pietwauters/ImprovedTesterAfterGenova/Enclosure/TesterInclSwitchv0.2e.3mf

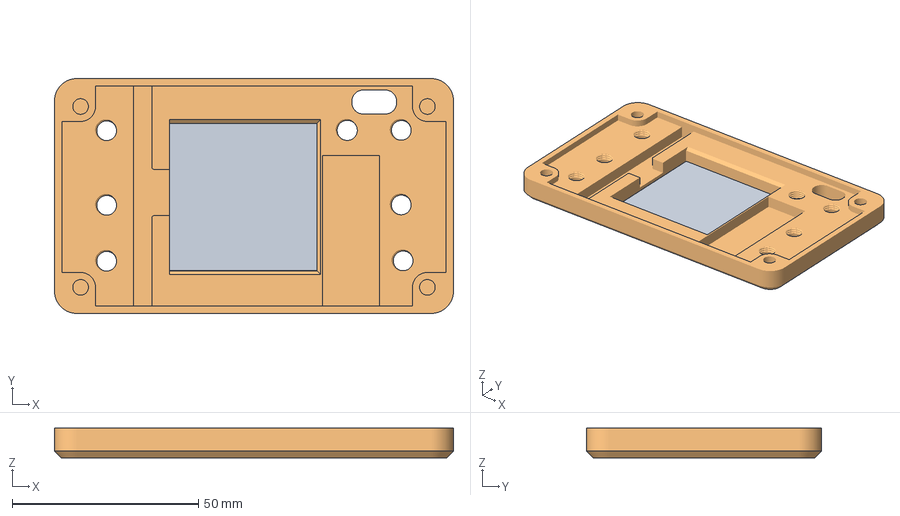
[picture p1: CAD file, 2026-11-05]
Enclosure/TesterInclSwitchv0.2e.3mf
107.0 x 63.0 x 8.00 mm
