pietwauters/ImprovedTesterAfterGenova/Enclosure/TesterInclSwitchv0.2eTop.3mf

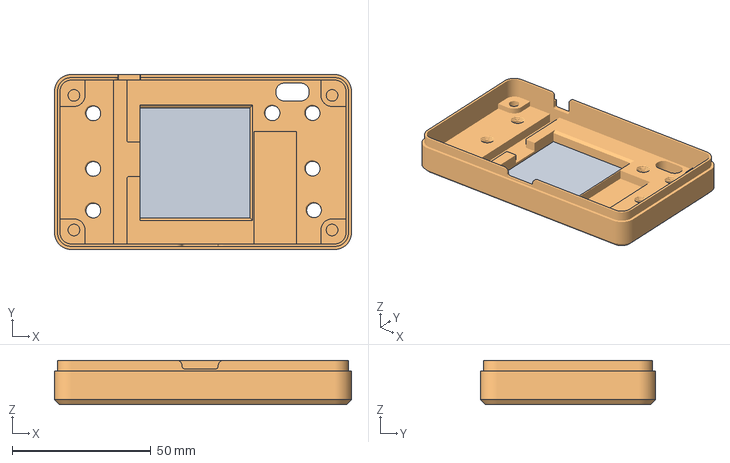
[picture p2: CAD file, 2026-11-05]
Enclosure/TesterInclSwitchv0.2eTop.3mf
107.0 x 63.0 x 16.0 mm
