pietwauters/ImprovedTesterAfterGenova/(list of files, cad)

Other CAD files:
Enclosure/TesterInclSwitchv0.2fTopWithout.3mf
