pietwauters/ImprovedTesterAfterGenova/src/main.cpp

#include <Arduino.h>
#include <AsyncTCP.h>
#include <ESPAsyncWebServer.h>
#include <ElegantOTA.h>
#include <WiFi.h>

#include <algorithm>
#include <cinttypes>
#include <cstdio>
#include <iostream>
#include <map>
#include <vector>

#include "PreferencesWrapper.h"
#include "SettingsManager.h"
#include "WS2812BLedMatrix.h"
#include "CalibrationService.h"
#include "WebTerminal.h"
#include "WiFiPowerManager.h"
#include "driver/adc.h"
#include "esp_adc_cal.h"
#include "version.h"
// Only include Bluetooth header if it's enabled in config
#ifdef CONFIG_BT_ENABLED
#include "esp_bt.h"
#endif
#include "esp_task_wdt.h"
#include "esp_timer.h"
#include "esp_wifi.h"
#include "freertos/task.h"  // Required for vTaskList()
#include "resitancemeasurement.h"
#include "terminal.html.h"
using namespace std;

#include <freertos/FreeRTOS.h>
#include <freertos/task.h>

#include "DisplayManager.h"
#include "DeepSleepHandler.h"
#include "GpioHoldManager.h"
#include "Hardware.h"  // HARDWARE_REV_STR
#include "RTOSUtilities.h"
#include "USBSerialTerminal.h"
#include "adc_calibrator.h"
#include "driver/gpio.h"  // Required for gpio_pad_select_gpio()
#include "driver/rtc_io.h"
#include "esp_log.h"
#include "soc/io_mux_reg.h"  // For IO_MUX register definitions
#include "tester.h"

/*#include "ESP32Button.h"
 */

void disableRadioForTesting() {
    Serial.println("=== TEMPORARILY DISABLING RADIO FOR TESTING ===");

    // Disable WiFi if it was initialized
    WiFi.mode(WIFI_OFF);
    WiFi.disconnect(true);

// Disable Bluetooth (if available)
#if defined(CONFIG_BT_ENABLED)
    btStop();
#endif

    Serial.println("Radio disabled - WiFi and Bluetooth are off");
}
// Global tester instance
Tester* tester = nullptr;

int myRefs_Ohm[] = {0, 1, 2, 3, 4, 5, 6, 7, 8, 9, 10};
int StoredRefs_ohm[] = {0, 1, 2, 3, 4, 5, 6, 7, 8, 9, 10};

int Vmax = 2992;
volatile bool DoCalibration = false;
String LedLayout = LED_LAYOUT_DEFAULT;  // LED panel layout, see docs/LED_PANEL_LAYOUT.md
bool IgnoreCalibrationWarning = false;
bool ShowWelcome = true;
bool LowPowerMode = false;
bool EnableFoilLeakTest = false;
bool EnableReelMode = true;
int SpecialModeSleepTimeout = 60;  // s without a connection in epee/foil/lame mode before deep sleep
int CalibrationDisplayChannel = 0;  // Default to channel 0
bool CalibrationAutoMode = false;   // Auto mode flag
int Brightness = BRIGHTNESS_LOW;    // Default brightness level

// Below are the threshold values that determine color coding
// Bodycord thresholds
float BodycordThreshold = 1.0;
float ReelBodycordThreshold = 10.0f;  // Green threshold for reel-mode wire test (Ω)

// Foil thresholds
float FoilSingleWireThreshold = 1.0;
float FoilLoopThreshold = 2.0;
float FoilMassProbeThreshold = 5.0;

// Epee thresholds
float EpeeSingleWireThreshold = 1.0;
float EpeeLoopThreshold = 2.0;
float EpeeMassProbeThreshold = 5.0;

// Lamé thresholds
float LameThreshold = 5.0f;
void ResetToFIEThresholds() {
    // Bodycord thresholds
    BodycordThreshold = 1.0;
    ReelBodycordThreshold = 10.0f;

    // Foil thresholds
    FoilSingleWireThreshold = 1.0;
    FoilLoopThreshold = 2.0;
    FoilMassProbeThreshold = 5.0;

    // Epee thresholds
    EpeeSingleWireThreshold = 1.0;
    EpeeLoopThreshold = 2.0;
    EpeeMassProbeThreshold = 5.0;

    // Lamé thresholds
    LameThreshold = 5.0f;
}
AsyncWebServer server(80);
SettingsManager settings;
WebTerminal terminal(server);
USBSerialTerminal serialTerminal;  // Add this global variable

WS2812B_LedMatrix* LedPanel;

// Forward declarations
void synchronizeThresholdValues();
void LoadSettings();
void handleEchoCommand(ITerminal* term, const std::vector<String>& args);
void handleRebootCommand(ITerminal* term, const std::vector<String>& args);
void handleHelpCommand(ITerminal* term, const std::vector<String>& args);
void handleCalibrateCommand(ITerminal* term, const std::vector<String>& args);
void handleListCommand(ITerminal* term, const std::vector<String>& args);  // Add this
void handleSetCommand(ITerminal* term, const std::vector<String>& args);   // Add this
void handleLedTestCommand(ITerminal* term, const std::vector<String>& args);

// Command handler class declaration
class CommonCommandHandler {
   public:
    template <typename TerminalType>
    void registerTo(TerminalType* terminal) {
        terminal->registerCommand("echo", handleEchoCommand);
        terminal->registerCommand("reboot", handleRebootCommand);
        terminal->registerCommand("calibrate", handleCalibrateCommand);
        terminal->registerCommand("list", handleListCommand);
        terminal->registerCommand("set", handleSetCommand);
        terminal->registerCommand("help", handleHelpCommand);
        terminal->registerCommand("ledtest", handleLedTestCommand);
    }
};

// Create a single global command handler instance
CommonCommandHandler commandHandler;

ITerminal* currentTerminal = nullptr;

void handleCalibrateCommand(ITerminal* term, const std::vector<String>& args) {
    currentTerminal = term;  // Set global pointer
                             /*if (args.empty()) {
                                 term->printf("Calibrate command requires 'on' or 'off' [channel]\n");
                                 term->printf("Usage: calibrate on [0-2]  or  calibrate off\n");
                                 term->printf("Default: auto mode (tracks lowest value channel)\n");
                                 return;
                             }
                         
                             if (args[0] == "on") {
                                DoCalibration = true;
                                // Keep WiFi on during calibration
                                wifiPowerManager().keepWiFiOn("calibration");                                 // Set which channel to display
                                 if (args.size() > 1) {
                                     if (args[1] == "auto") {
                                         CalibrationAutoMode = true;
                                         CalibrationDisplayChannel = 0;
                                         term->printf("Calibration started in AUTO mode (lowest value channel)\n");
                                     } else {
                                         int channel = args[1].toInt();
                                         if (channel >= 0 && channel <= 2) {
                                             CalibrationAutoMode = false;
                                             CalibrationDisplayChannel = channel;
                                             term->printf("Calibration started for channel %d\n", CalibrationDisplayChannel);
                                         } else {
                                             term->printf("Invalid channel %d. Using AUTO mode.\n", channel);
                                             CalibrationAutoMode = true;
                                             CalibrationDisplayChannel = 0;
                                             term->printf("Calibration started in AUTO mode (lowest value channel)\n");
                                         }
                                     }
                                 } else {
                                     CalibrationAutoMode = true;
                                     CalibrationDisplayChannel = 0;
                                     term->printf("Calibration started in AUTO mode (lowest value channel)\n");
                                 }
                         
                             } else if (args[0] == "off") {
                                 DoCalibration = false;
                         
                             } else {
                                 term->printf("Unknown argument for Calibrate command\n");
                             }*/
    term->printf("This is a place holder to perform calibration\n");
    if (tester != nullptr) {
        term->printf("v_gpio = %f\n", tester->get_v_gpio());
        term->printf("r1r2 = %f\n", tester->get_r1_r2());
        term->printf("r_internal = %f\n", tester->get_r_internal());
    }
}

// Function to synchronize myRefs_Ohm with StoredRefs_ohm after settings changes
void synchronizeThresholdValues() {
    if (testerInstance) {
        testerInstance->UpdateThresholdsWithLeadResistance(testerInstance->getAverageLeadResistance());
    }
}

// This function should become part of the calibrationmodule
/*
void AdjustThreasholdForRealV() {
    static bool bInitialAdjustmentDone = false;
    static long TimeToTest = 0;

    // Only perform initial adjustment once at startup
    if (bInitialAdjustmentDone) {
        return;
    }

    int Vreal = 3300;
    bool OKToAdjust = true;
    testWiresOnByOne();

    if (millis() < TimeToTest) {
        return;
    }

    for (int j = 0; j < 3; j++) {
        if ((measurements[j][j] > 2500)) {
            if (measurements[j][j] < Vreal) {
                Vreal = measurements[j][j];
            }
        } else {
            OKToAdjust = false;
            j = 3;
        }
    }

    if (OKToAdjust) {
        float factor = (float)Vreal / (float)Vmax;
        for (int i = 0; i < 11; i++) {
            myRefs_Ohm[i] = (int)(StoredRefs_ohm[i] * factor);
        }
        bInitialAdjustmentDone = true;  // Mark as completed
    } else {
        // If conditions aren't met, try again in 1 second
        TimeToTest = millis() + 1000;
    }
}
*/
bool CalibrationEnabled;

String deviceName;
void handleListCommand(ITerminal* term, const std::vector<String>& args) {
    term->printf("Available settings:\n");
    term->printf("===================\n");

    term->printf("Integer settings:\n");
    term->printf("  Brightness          : %d (Display brightness 1-255)\n", Brightness);

    term->printf("\nBoolean settings:\n");
    term->printf("  bCalibrate          : %s (Perform Calibration?)\n", CalibrationEnabled ? "true" : "false");
    term->printf("  IgnoreCalibrationWarning          : %s (Ignore warning that Calibration is needed?)\n",
                 IgnoreCalibrationWarning ? "true" : "false");

    term->printf("\nString settings:\n");
    term->printf("  LedLayout           : %s (LED panel: corner of LED 0 + first direction, e.g. BL-V)\n",
                 LedLayout.c_str());
    term->printf("  name                : %s (Device Name)\n", deviceName.c_str());

    term->printf("\nNote: Use the web interface to modify these settings\n");
}

void handleSetCommand(ITerminal* term, const std::vector<String>& args) {
    if (args.size() < 2) {
        term->printf("Usage: set <setting_name> <value>\n");
        term->printf("Available settings: bCalibrate, IgnoreCalibrationWarning, LedLayout, Brightness, name\n");
        term->printf("Example: set name \"MyTester\"\n");
        // term->printf("Example: set myRefs_Ohm 0,1,2,3,4,5,6,7,8,9,12\n");
        return;
    }

    String settingName = args[0];
    String value = args[1];

    term->printf("Setting '%s' to '%s'...\n", settingName.c_str(), value.c_str());

    // Integer settings
    if (settingName == "Brightness") {
        int newValue = value.toInt();
        if (newValue < 1 || newValue > 255) {
            term->printf("Error: Brightness must be between 1 and 255\n");
            return;
        }
        Brightness = newValue;
        term->printf("✓ Set Brightness = %d\n", newValue);

        // Boolean settings
    } else if (settingName == "bCalibrate") {
        if (value == "true" || value == "1") {
            CalibrationEnabled = true;
            term->printf("✓ Set bCalibrate = true\n");
        } else if (value == "false" || value == "0") {
            CalibrationEnabled = false;
            term->printf("✓ Set bCalibrate = false\n");
        } else {
            term->printf("Error: bCalibrate must be 'true' or 'false'\n");
            return;
        }

        // String settings
    } else if (settingName == "LedLayout") {
        if (!WS2812B_LedMatrix::isValidLayout(value)) {
            term->printf("Error: LedLayout must be <corner>-<direction>[-P], corner BL/BR/TL/TR, direction V/H\n");
            term->printf("       e.g. BL-V = LED 0 bottom-left, first run going up. Try it first with: ledtest BL-V\n");
            return;
        }
        LedPanel->setLayout(value);
        LedLayout = LedPanel->getLayout();  // normalized (upper case)
        term->printf("✓ Set LedLayout = %s\n", LedLayout.c_str());
    } else if (settingName == "name") {
        // Remove quotes if present
        if (value.startsWith("\"") && value.endsWith("\"")) {
            value = value.substring(1, value.length() - 1);
        }
        deviceName = value;
        term->printf("✓ Set name = \"%s\"\n", value.c_str());

        // Array settings
    } else {
        term->printf("Error: Unknown setting '%s'\n", settingName.c_str());
        term->printf("Available:  R0, Vmax, bCalibrate, LedLayout, Brightness, name\n");
        return;
    }

    // Save to flash with feedback
    term->printf("Saving to flash...\n");
    settings.save();
    term->printf("✓ Settings successfully saved to flash!\n");
    term->printf("✓ Setting change complete.\n");
}

void LoadSettings() {
    // Register ALL settings before calling load(), so every setting is
    // populated from NVS on startup (not just the ones registered first).

    settings.addBool("bCalibrate", "Perform Calibration?", &CalibrationEnabled);
    settings.addBool("IgnoreCalibrationWarning", "Ignore warning to Calibrate?", &IgnoreCalibrationWarning);
    settings.addBool("ShowWelcome", "Show welcome lights (for debugging)?", &ShowWelcome);
    settings.addBool("LowPowerMode", "Apply low power settings (slightly lower response times)", &LowPowerMode);
    settings.addBool("EnableFoilLeakTest", "Enable foil tip leaktest (expert)", &EnableFoilLeakTest);
    settings.addBool("EnableReelMode", "Enable cable reel mode (short sockets A+B on top)", &EnableReelMode);
    settings.addInt("SpecialModeSleepTimeout",
                    "Seconds with nothing connected in epee/foil/lame mode before sleep (0 = never, needs LowPowerMode)",
                    &SpecialModeSleepTimeout);

    settings.addInt("Brightness", "Display brightness 1-255", &Brightness);
    settings.addString("name", "Device Name", &deviceName);
    settings.addString("LedLayout", "LED panel layout: corner of LED 0 + first direction (BL-V, BR-H, ...)", &LedLayout);
    // settings.addInt("R1_R2", "R1_R2 (total resistance (Ron + 2 x 47)", &R0);
    // settings.addInt("Vmax", "Vmax in mV", &Vmax);

    settings.addSection("Advanced", "Advanced Settings", 1, true, true);
    settings.addSubsection("WireThresholds", "Thresholds for body cord", "Advanced", 1, true, true);
    settings.addSubsection("FoilThresholds", "Thresholds for foil", "Advanced", 2, true, true);
    settings.addSubsection("EpeeThresholds", "Thresholds for epee", "Advanced", 3, true, true);
    settings.addSubsection("LameThresholds", "Thresholds for lamé", "Advanced", 4, true, true);
    settings.setSectionDescription("Advanced",
                                   "This section lets you modify default threshold that are used in color coding. "
                                   "Only change the defaults if you know what you are doing!");
    // Bodycord thresholds
    settings.addFloat("BodycordThreshold", "Single wire threshold", &BodycordThreshold, "WireThresholds");
    settings.addFloat("ReelBodycordThreshold", "Reel single wire threshold", &ReelBodycordThreshold, "WireThresholds");

    // Foil thresholds
    settings.addFloat("FoilSingleWireThreshold", "Single wire threshold (connector - tip)", &FoilSingleWireThreshold,
                      "FoilThresholds");
    settings.addFloat("FoilLoopThreshold", "Connector-connector threshold", &FoilLoopThreshold, "FoilThresholds");
    settings.addFloat("FoilMassProbeThreshold", "Mass pobe threshold", &FoilMassProbeThreshold, "FoilThresholds");

    // Epee thresholds
    settings.addFloat("EpeeSingleWireThreshold", "Single wire threshold (connector - tip)", &EpeeSingleWireThreshold,
                      "EpeeThresholds");
    settings.addFloat("EpeeLoopThreshold", "Connector-connector threshold", &EpeeLoopThreshold, "EpeeThresholds");
    settings.addFloat("EpeeMassProbeThreshold", "Mass pobe threshold", &EpeeMassProbeThreshold, "EpeeThresholds");

    // Lame thresholds
    settings.addFloat("LameThreshold", "Lamé threshold", &LameThreshold, "LameThresholds");

    settings.addButton(
        "reset_fie", "Reset to FIE",
        []() {
            ResetToFIEThresholds();
            settings.save();  // persist the reset values to NVS
        },
        "Advanced");

    // Now load — all settings are registered so every value is restored from NVS
    settings.begin("Settings");  // for Preferences namespace
    settings.load();
    if (!settings.keyExists("ShowWelcome")) {
        ShowWelcome = true;
        settings.save();
    }
    if (Brightness < 1) {
        Brightness = BRIGHTNESS_NORMAL;
    }
}

// --- WiFi bring-up policy -----------------------------------------------------
// The AP's current draw stacks onto charge current + LED current during boot and
// can push the MCP73871's 500 mA USB input limit into oscillation (brownout).
// So: bring WiFi up only after the welcome sequence + calibration have run, and
// at minimal TX power.
#ifndef WIFI_START_DELAY_MS
#define WIFI_START_DELAY_MS \
    5000  // ms after setup() before the AP comes up (bump if it still browns out during calibration)
#endif
#ifndef WIFI_TX_POWER
#define WIFI_TX_POWER WIFI_POWER_MINUS_1dBm  // absolute minimum; raise (e.g. WIFI_POWER_5dBm) if the AP is unreachable
#endif
static uint32_t g_wifiStartAt = 0;  // 0 = never start WiFi (e.g. deep-sleep wake)
static bool g_wifiStarted = false;

void SetupNetworkStuff() {
    // Don't let WiFi mode changes write the driver config to NVS/flash. The
    // flash write stalls both cores for several ms; combined with WiFiPowerManager
    // tearing WiFi down on timeout, that used to corrupt an in-flight LED frame.
    WiFi.persistent(false);
    WiFi.mode(WIFI_AP);
    WiFi.softAP("Tester", "01041967");
    WiFi.setTxPower(WIFI_TX_POWER);  // minimal - keep the AP's current draw low

    // Setup ElegantOTA with callbacks for WiFi power management
    ElegantOTA.begin(&server);
    ElegantOTA.onStart([]() { wifiPowerManager().onOTAStart(); });
    ElegantOTA.onEnd([](bool success) {
        if (success) {
            wifiPowerManager().onOTAEnd();
        } else {
            wifiPowerManager().onOTAError();
        }
    });

    Serial.println(WiFi.softAPIP());
    terminal.begin();

    // Register the single command handler to web terminal
    commandHandler.registerTo(&terminal);
    registerCalibrationApi(server, deviceName);

    server.begin();
    terminal.printf("HTTP server started\n");

    settings.addWebEndpoints(server);
    settings.setPostSaveCallback(synchronizeThresholdValues);

    // Initialize WiFi Power Manager after WiFi setup
    wifiPowerManager().begin();

    g_wifiStarted = true;
    Serial.printf("[WiFi] AP up at TX power level %d (%lu ms after boot)\n", (int)WIFI_TX_POWER,
                  (unsigned long)millis());
}

void setupSerialTerminal() {
    serialTerminal.begin();

    // Register the same command handler to serial terminal
    commandHandler.registerTo(&serialTerminal);
}

// Move the command handler implementations here (before they're used)
void handleEchoCommand(ITerminal* term, const std::vector<String>& args) {
    String response;
    for (auto& arg : args) {
        response += arg + " ";
    }
    term->send(response);
}

void handleRebootCommand(ITerminal* term, const std::vector<String>& args) {
    term->send("Rebooting...");
    ESP.restart();
}

void handleHelpCommand(ITerminal* term, const std::vector<String>& args) {
    term->send("Available commands:");
    term->send("  echo <text>          - Echo back the text");
    term->send("  reboot               - Restart the device");
    term->send("  calibrate            - Start calibration");
    term->send("  list                 - Show available settings");
    term->send("  set <name> <value>   - Change a setting");
    term->send("  ledtest [layout]     - Check the LED panel layout (upright F = correct)");
    term->send("  help                 - Show this help message");
}

// ledtest          : draw the layout test pattern with the current LedLayout
// ledtest <layout> : preview another layout (not saved; use 'set LedLayout')
void handleLedTestCommand(ITerminal* term, const std::vector<String>& args) {
    String previous = LedPanel->getLayout();
    if (!args.empty()) {
        if (!LedPanel->setLayout(args[0])) {
            term->printf("Error: '%s' is not a valid layout (e.g. BL-V, BR-H, TL-V-P)\n", args[0].c_str());
            return;
        }
    }
    String tested = LedPanel->getLayout();
    term->printf("Layout %s: the F should be upright and readable (green).\n", tested.c_str());
    term->printf("Red = chain LED #0, orange = LED #1 -> they show the start corner and first direction.\n");
    LedPanel->LayoutTest();
    delay(5000);
    LedPanel->setLayout(previous);  // preview only
    LedPanel->ClearAll();
    if (tested != previous) {
        term->printf("Not saved. If this one was right: set LedLayout %s\n", tested.c_str());
    }
}

void setup() {
    // put your setup code here, to run once:
    setCpuFrequencyMhz(240);  // Set CPU frequency to 240 MHz
    // Pins held through deep sleep (drivers, BOOST_EN, PWRLed) ignore any new
    // configuration until released
    if (esp_sleep_get_wakeup_cause() != ESP_SLEEP_WAKEUP_UNDEFINED) {
        DeepSleepHandler::releaseAllHolds();
    }
#if HARDWARE_REV == 3
    gpio_reset_pin(BOOST_EN);
    gpio_set_direction(BOOST_EN, GPIO_MODE_OUTPUT);
    gpio_set_level(BOOST_EN, 1);  // 1 = HIGH, 0 = LOW
    delay(50);
    gpio_reset_pin(PWRLed);
    gpio_set_direction(PWRLed, GPIO_MODE_OUTPUT);
    gpio_set_level(PWRLed, 1);  // 1 = HIGH, 0 = LOW
#endif
    Serial.begin(115200);
    esp_log_level_set("*", ESP_LOG_ERROR);

    // Early, unmissable banner so you can confirm the flashed binary matches the
    // board in front of you before anything else runs.
    delay(50);
    Serial.printf("\n\n==================================================\n");
    Serial.printf("  Improved Tester   fw %s\n", APP_VERSION);
    Serial.printf("  HARDWARE REVISION: %s   (env hw_rev%s)\n", HARDWARE_REV_STR, HARDWARE_REV_STR);
    Serial.printf("==================================================\n\n");

    LoadSettings();
    Display.begin();

    Display.print(DisplayManager::utf8ToCp437(deviceName));
    Display.printf("\n\n%s hw%s", APP_VERSION, HARDWARE_REV_STR);
    Display.display();  // flush framebuffer to screen    // Set global log level to ERROR only - suppress INFO logs
                        // from libraries

    LedPanel = new WS2812B_LedMatrix();
    if (!LedPanel->setLayout(LedLayout)) {
        Serial.printf("Invalid LedLayout '%s' in settings, using default %s\n", LedLayout.c_str(),
                      LED_LAYOUT_DEFAULT);
        LedLayout = LED_LAYOUT_DEFAULT;
        LedPanel->setLayout(LedLayout);
    }
    LedPanel->begin();
    LedPanel->ClearAll();

    LedPanel->ConfigureBlinking(12, LedPanel->m_Red, 100, 2000, 0);
    LedPanel->SetBrightness((uint8_t)Brightness);  // Set the brightness level for the LED panel
    esp_sleep_wakeup_cause_t wakeup_reason = esp_sleep_get_wakeup_cause();
    if (wakeup_reason == ESP_SLEEP_WAKEUP_UNDEFINED) {
        if (ShowWelcome) {
            LedPanel->SequenceTest();
        }
    }

    // Setup serial terminal first, before other initialization
    setupSerialTerminal();

    esp_task_wdt_init(20, true);
    esp_task_wdt_add(NULL);
    Serial.printf("CPU Freq: %d MHz\n", getCpuFrequencyMhz());
    Serial.printf("Arduino setup()/loop() running on core %d (expect 0)\n", xPortGetCoreID());
    printf("App version: %s   Hardware rev: %s\n", APP_VERSION, HARDWARE_REV_STR);
    init_AD();
    Set_IODirectionAndValue(IODirection_br_bl, IOValues_br_bl);

    tester = new Tester(LedPanel);
    tester->setIgnoreCalibrationWarning(IgnoreCalibrationWarning);

    // Start the tester task
    tester->begin(CalibrationEnabled);

    // Remove the idle task from the WDT (do this for both cores)
    esp_task_wdt_delete(xTaskGetIdleTaskHandleForCPU(0));
    esp_task_wdt_delete(xTaskGetIdleTaskHandleForCPU(1));

    if (wakeup_reason == ESP_SLEEP_WAKEUP_UNDEFINED) {
        // Defer the actual AP bring-up to loop(), WIFI_START_DELAY_MS from now,
        // so it lands after the welcome sequence and calibration.
        g_wifiStartAt = millis() + WIFI_START_DELAY_MS;
    }
    //  Explicitly disable Wifi and Bluetooth
    // disableRadioForTesting();
    // Create the tester instance
}

void loop() {
    vTaskDelay(50 / portTICK_PERIOD_MS);

    // Always run serial terminal
    serialTerminal.loop();
    esp_task_wdt_reset();

    if (!g_wifiStarted) {
        // Deferred AP bring-up (see WIFI_START_DELAY_MS). Nothing network-side
        // exists yet, so don't touch the other handlers.
        if (g_wifiStartAt != 0 && (int32_t)(millis() - g_wifiStartAt) >= 0) {
            SetupNetworkStuff();
        }
        return;
    }

    // Run WiFi power management
    wifiPowerManager().loop();
    esp_task_wdt_reset();

    ElegantOTA.loop();
    esp_task_wdt_reset();
    terminal.loop();
    esp_task_wdt_reset();
}

extern "C" void app_main() {
    // esp_sleep_enable_timer_wakeup(1500000);  // 1.5 seconds in microseconds to
    // esp_light_sleep_start();                 // or esp_deep_sleep_start() if you want a full reset
    /*esp_sleep_wakeup_cause_t cause = esp_sleep_get_wakeup_cause();

    if (cause == ESP_SLEEP_WAKEUP_UNDEFINED) {
        // Fresh power-on or reset
        // Configure wakeup source: 2 seconds timer
        esp_sleep_enable_timer_wakeup(200000);  // microseconds
        esp_deep_sleep_start();
        // never returns
    }
*/
    // Call Arduino setup and loop
    initArduino();  // Initialize Arduino if needed
    setup();
    // printTasks(); // Print tasks during setup      // Call the Arduino setup function
    while (true) {
        loop();  // Call the Arduino loop function
    }
}
