pietwauters/ImprovedTesterAfterGenova/src/tester.cpp

#include "tester.h"

#include "CalibrationService.h"
#include "CalibrationStore.h"
#include "DisplayManager.h"
#include "Hardware.h"
#include "MeasurementHardware.h"
#include "globals.h"  // For DoCalibration and other globals

// Global instance
Tester* testerInstance = nullptr;

// OLED is managed by DisplayManager

#if HARDWARE_REV == 3
// Wake-on-connect deep sleep (hw_rev3 only: every driver pin is an RTC pad).
// Ar, Bl, Cl are held HIGH. Br, Cr, Al are held as inputs with the internal
// ~45k pull-down, which pulls their sense node LOW through R1 (the sense pins
// GPIO34-39 have no pulls of their own). A connection from a HIGH terminal to a
// pulled-down one lifts that sense pin to ~3.3V and wakes the chip (EXT1
// ANY_HIGH). This catches body cords, epee (Ar-Cr), foil (Ar-Br), top lame
// (Cr-Cl) and the reel short (Al-Bl). Bottom lame (Br-Cr) joins two pulled-down
// terminals and does NOT wake the tester.
static const uint8_t kSleepHighDrivers[] = {ar_driver, bl_driver, cl_driver};
static const uint8_t kSleepPulldownDrivers[] = {br_driver, cr_driver, al_driver};
static const adc1_channel_t kSleepWakeSense[] = {br_analog, cr_analog, piste_analog};
// A wake sense pin above this while idle means something is connected; sleeping
// would wake straight away, so stay awake instead. Well below the ~0.75*VDD
// wake level, so marginal (leaky) connections also keep the tester awake.
constexpr int kSleepSenseIdleMaxMv = 400;

// Apply the sleep pin configuration while awake and check that all wake sense
// pins read LOW. The next measurement reconfigures the driver pins again.
static bool isIdleForWakeOnConnect() {
    for (uint8_t pin : kSleepHighDrivers) {
        pinMode(pin, OUTPUT);
        digitalWrite(pin, HIGH);
    }
    for (uint8_t pin : kSleepPulldownDrivers) {
        pinMode(pin, INPUT_PULLDOWN);
    }
    vTaskDelay(5 / portTICK_PERIOD_MS);
    bool idle = true;
    for (adc1_channel_t channel : kSleepWakeSense) {
        int mv = MeasurementHardware::getCalibratedVoltage(adc1_get_raw(channel), channel);
        if (mv > kSleepSenseIdleMaxMv) {
            idle = false;
        }
    }
    for (uint8_t pin : kSleepPulldownDrivers) {
        pinMode(pin, INPUT);  // drop the pull-down, it would load the measurement
    }
    return idle;
}

static void enterWakeOnConnectSleep(DeepSleepHandler& handler) {
    handler.clearAllPins();
    for (uint8_t pin : kSleepHighDrivers) {
        handler.addHoldPin((gpio_num_t)pin, 1);
    }
    for (uint8_t pin : kSleepPulldownDrivers) {
        handler.addPulldownPin((gpio_num_t)pin);
    }
    handler.addHoldPin(BOOST_EN, 0);
    handler.addHoldPin(PWRLed, 0);
    for (adc1_channel_t channel : kSleepWakeSense) {
        gpio_num_t gpio;
        adc1_pad_get_io_num(channel, &gpio);
        handler.addWakeupPin(gpio, WakeupTrigger::WAKE_HIGH);
    }
    handler.enterDeepSleep();
}
#endif

Tester::Tester(WS2812B_LedMatrix* ledPanelRef)
    : ledPanel(ledPanelRef),
      currentState(Waiting),
      timeToSwitch(WIRE_TEST_1_TIMEOUT),
      noWireTimeout(NO_WIRES_PLUGGED_IN_TIMEOUT),
      allGood(true),
      lastSpecialTestExit(0),
      testerTaskHandle(nullptr)

{
    testerInstance = this;
}

Tester::~Tester() {
    stop();
    testerInstance = nullptr;
}

// Body cord wires: index 0 = A (code Cr-Cl), 1 = B (Ar-Al), 2 = C (Br-Bl)
static const int kWirePath[3] = {PathClCr, PathAlAr, PathBlBr};

// Calibration path index for a pair of terminals (either order); -1 when there is none
static int pathIndexFor(Terminal a, Terminal b) {
    static const char* const names[] = {"Ar", "Br", "Cr", "Al", "Bl", "Cl"};  // Terminal enum order
    char name[8];
    snprintf(name, sizeof(name), "%s-%s", names[(int)a], names[(int)b]);
    const CalibrationPath* p = findCalibrationPath(name);
    if (p == nullptr) {
        snprintf(name, sizeof(name), "%s-%s", names[(int)b], names[(int)a]);
        p = findCalibrationPath(name);
    }
    return p != nullptr ? calibrationPathIndex(*p) : -1;
}

float Tester::ohms(Terminal a, Terminal b, float mv) const {
    return mycalibrator.resistanceFor(pathIndexFor(a, b), mv / 1000.0f);
}

void Tester::UpdateThresholdsWithLeadResistance(float RLead) {
    // Thresholds for mode detection and generic checks: on the calibrated connection
    for (int i = 0; i < 11; i++) {
        myRefs_Ohm[i] = mycalibrator.get_mv_threshold(1.0f * i, RLead);
        // printf("Threshold[%d] = %d mV\n", i, myRefs_Ohm[i]);
    }
    Ohm_20 = mycalibrator.get_mv_threshold(20.0f, RLead);
    Ohm_50 = mycalibrator.get_mv_threshold(50.0f, RLead);

    // Each colour breakpoint in mV for the connection it is compared with
    auto mv = [&](int path, float ohm) { return mycalibrator.mvThresholdFor(path, ohm, RLead); };

    // Lamé color breakpoints (×1, ×2, ×4 of LameThreshold): bottom (Br-Cr) and top (Cr-Cl)
    LameBottom_Green = mv(PathBrCr, LameThreshold);
    LameBottom_Yellow = mv(PathBrCr, LameThreshold * 2.0f);
    LameBottom_Orange = mv(PathBrCr, LameThreshold * 4.0f);
    LameTop_Green = mv(PathClCr, LameThreshold);
    LameTop_Yellow = mv(PathClCr, LameThreshold * 2.0f);
    LameTop_Orange = mv(PathClCr, LameThreshold * 4.0f);

    // Foil body cord (loop, Ar-Br) breakpoints
    FoilLoop_Green = mv(PathArBr, FoilLoopThreshold);
    FoilLoop_Yellow = mv(PathArBr, FoilLoopThreshold * 2.0f);
    FoilLoop_Orange = mv(PathArBr, FoilLoopThreshold * 4.0f);

    // Foil/Epee tip wire (single wire, Ar-Cl) breakpoints
    FoilTip_Green = mv(PathArCl, FoilSingleWireThreshold);
    FoilTip_Yellow = mv(PathArCl, FoilSingleWireThreshold * 2.0f);
    FoilTip_Orange = mv(PathArCl, FoilSingleWireThreshold * 4.0f);

    EpeeTip_Green = mv(PathArCl, EpeeSingleWireThreshold);
    EpeeTip_Yellow = mv(PathArCl, EpeeSingleWireThreshold * 2.0f);
    EpeeTip_Orange = mv(PathArCl, EpeeSingleWireThreshold * 4.0f);

    // Foil/Epee probe (BrCl) breakpoints — shared setting
    Probe_Green = mv(PathBrCl, FoilMassProbeThreshold);
    Probe_Yellow = mv(PathBrCl, FoilMassProbeThreshold * 2.0f);
    Probe_Orange = mv(PathBrCl, FoilMassProbeThreshold * 4.0f);

    // Epee return wire (loop, Ar-Cr) breakpoints
    EpeeLoop_Green = mv(PathArCr, EpeeLoopThreshold);
    EpeeLoop_Yellow = mv(PathArCr, EpeeLoopThreshold * 2.0f);
    EpeeLoop_Orange = mv(PathArCr, EpeeLoopThreshold * 4.0f);

    // Epee leak thresholds: Even large resistance leaks could lead to issues
    EpeeLeak = mycalibrator.get_mv_threshold(550, RLead);
    FoilLeakThreshold = mycalibrator.get_mv_threshold(550, RLead);

    // Main wire test (body cord) thresholds per wire (×1, ×2 green/yellow); broken (×10) and reel
    // broken (×5) are far above any per-connection difference and stay on the calibrated connection
    for (int w = 0; w < 3; w++) {
        Bodycord_Green[w] = mv(kWirePath[w], BodycordThreshold);
        Bodycord_Yellow[w] = mv(kWirePath[w], BodycordThreshold * 2.0f);
        Reel_Green[w] = mv(kWirePath[w], ReelBodycordThreshold);
        Reel_Yellow[w] = mv(kWirePath[w], ReelBodycordThreshold * 2.0f);
        WireOneOhm[w] = mv(kWirePath[w], 1.0f);
    }
    Bodycord_Broken = mycalibrator.get_mv_threshold(BodycordThreshold * 10.0f, RLead);
    Reel_Broken = mycalibrator.get_mv_threshold(ReelBodycordThreshold * 5.0f, RLead);

    // mycalibrator.print_roundtrip_diagnostics(RLead);
}

void Tester::begin(bool ForceCalibration) {
    Display.begin();
    mycalibrator.begin(br_analog, bl_analog);
    calibrationService.begin();
    // Try to load existing calibration (fitted on the current, bidirectional readings)
    EmpiricalModel stored;
    if ((ForceCalibration) || !calibrationStore.loadActive(kDefaultCalibrationPath, stored)) {
        // No existing calibration, run interactive calibration
        mycalibrator.DoFactoryReset();
        DefaultBlinkColor = LedPanel->m_Red;

        if (!IgnoreCalibrationWarning) {
            LedPanel->Draw_C(LedPanel->m_Red);
            LedPanel->myShow();

            if (mycalibrator.calibrate_interactively_empirical()) {
                calibrationStore.save(kDefaultCalibrationPath, mycalibrator.model(), 0);
                LedPanel->ClearAll();
                LedPanel->myShow();

                DefaultBlinkColor = LedPanel->m_Green;
            } else {
                mycalibrator.DoFactoryReset();
                DefaultBlinkColor = LedPanel->m_Red;
            }
        }
    } else {
        mycalibrator.setModel(stored);
        DefaultBlinkColor = LedPanel->m_Green;
    }
    calibrationService.setActiveModel(mycalibrator.model());
    // The tester's own corrections (B-B, C-C from a calibration) replace the table values
    for (int i = 0; i < kNumCalibrationPaths; i++) {
        PathCorrection c;
        if (calibrationStore.loadCorrection(kCalibrationPaths[i], c)) {
            mycalibrator.setCorrection(i, c);
        }
    }
    LedPanel->SetBlinkColor(DefaultBlinkColor);
    AverageLeadResistance = rtc.retrieve("LeadR", 0.0f);

    if (AverageLeadResistance > 0.0f) {
        LedPanel->SetBlinkColor(LedPanel->m_Blue);
    }
    UpdateThresholdsWithLeadResistance(0.0);
    SetWiretestMode(false);  // Normal mode, not Reel testing
    LedPanel->RestartBlink();

    // Below code lets you make a difference in lowpower time between cold boot and deep sleep
    esp_sleep_wakeup_cause_t wakeup_reason = esp_sleep_get_wakeup_cause();
    if (wakeup_reason == ESP_SLEEP_WAKEUP_UNDEFINED) {
        StartForLowPower = millis() + 90000;
    } else {
        restartSleepGrace();
    }
    /*
    long starttime = millis();
    for (int i = 0; i < 100; i++) {
        testWiresOnByOne();
        esp_task_wdt_reset();
    }
    long Duration = millis() - starttime;
    printf("Total duration = %d\n", Duration);
    printf("Time for a single sample = %d µs\n", Duration * 10 / 9);
*/
    // Create the tester task
    xTaskCreatePinnedToCore(testerTaskWrapper, "TesterTask",
                            8192,  // Stack size
                            this,  // Parameter passed to task
                            1,     // Priority
                            &testerTaskHandle,
                            1  // Core ID
    );
    // Display.clear();
}

void Tester::stop() {
    if (testerTaskHandle != nullptr) {
        vTaskDelete(testerTaskHandle);
        testerTaskHandle = nullptr;
    }
}

void Tester::testerTaskWrapper(void* parameter) {
    Tester* tester = static_cast<Tester*>(parameter);
    tester->taskLoop();
}

void Tester::taskLoop() {
    // Add watchdog for this task
    esp_task_wdt_add(NULL);
    printf("TesterTask running on core %d (expect 1)\n", xPortGetCoreID());

    while (true) {
        esp_task_wdt_reset();

        if (currentState == Waiting || currentState == Calibrating) {
            applyQueuedModel();
        }
        if (currentState != Calibrating && calibrationService.isRequested()) {
            enterCalibratingState();
        }

        switch (currentState) {
            case Waiting:
                handleWaitingState();
                break;

            case Calibrating:
                handleCalibratingState();
                break;

            case WireTesting_1:
                handleWireTestingState1();
                break;

            case WireTesting_2:
                handleWireTestingState2();
                break;

            default:
                // Should not reach here
                currentState = Waiting;
                break;
        }

        esp_task_wdt_reset();
        vTaskDelay(5 / portTICK_PERIOD_MS);  // Small delay to prevent watchdog issues
    }
}

// A model saved or restored over the web API: use it for all thresholds
void Tester::applyQueuedModel() {
    bool changed = false;
    int pathIndex;
    PathCorrection c;
    while (calibrationService.takeQueuedCorrection(pathIndex, c)) {
        mycalibrator.setCorrection(pathIndex, c);
        changed = true;
    }
    EmpiricalModel m;
    if (calibrationService.takeQueuedModel(m)) {
        mycalibrator.setModel(m);
        calibrationService.setActiveModel(m);
        DefaultBlinkColor = LedPanel->m_Green;
        changed = true;
    }
    if (changed) {
        UpdateThresholdsWithLeadResistance(0.0);
        SetWiretestMode(false);
    }
}

void Tester::enterCalibratingState() {
    currentState = Calibrating;
    ShowingShape = SHAPE_NONE;
    SetWiretestMode(false);
    calibrationService.setActiveModel(mycalibrator.model());
    calibrationService.setActive(true);
    printf("[Cal] session started on path %s\n", calibrationService.path().name);
    calLedColor_ = ledPanel->m_Blue;
    calFlashUntil_ = 0;
    calibrationService.takeFeedback();  // drop feedback from an earlier session
    showCalibrationLed(calLedColor_);
    Display.setMode("Calibrating");
    Display.showMode();
}

void Tester::showCalibrationLed(uint32_t color) {
    ledPanel->ClearAll();
    ledPanel->Draw_C(color);
    ledPanel->myShow();
}

// Measure the selected path continuously; the web API reads the averaged sample
void Tester::handleCalibratingState() {
    switch (calibrationService.takeFeedback()) {
        case CalFeedbackReset:
            calLedColor_ = ledPanel->m_Blue;
            calFlashUntil_ = 0;
            showCalibrationLed(calLedColor_);
            break;
        case CalFeedbackCaptured:
            calFlashUntil_ = millis() + 700;
            showCalibrationLed(ledPanel->m_Green);
            break;
        case CalFeedbackPass:
            calLedColor_ = ledPanel->m_Green;
            calFlashUntil_ = 0;
            showCalibrationLed(calLedColor_);
            break;
        case CalFeedbackFail:
            calLedColor_ = ledPanel->m_Red;
            calFlashUntil_ = 0;
            showCalibrationLed(calLedColor_);
            break;
        default:
            break;
    }
    if (calFlashUntil_ != 0 && (long)(millis() - calFlashUntil_) >= 0) {
        calFlashUntil_ = 0;
        showCalibrationLed(calLedColor_);
    }

    if (!calibrationService.isRequested()) {
        printf("[Cal] session ended: /api/cal/end\n");
        leaveCalibratingState();
        return;
    }
    if (calibrationService.idleTimedOut()) {
        printf("[Cal] session ended: no API call for %lu s\n", CalibrationService::IdleTimeoutMs / 1000UL);
        leaveCalibratingState();
        return;
    }
    const CalibrationPath& path = calibrationService.path();
    EmpiricalResistorCalibrator::EmpiricalReading reading =
        mycalibrator.measure(path, CalibrationService::ReadingsPerSample, false);
    calibrationService.pushReading(path, reading);
}

void Tester::leaveCalibratingState() {
    calibrationService.setActive(false);
    wifiPowerManager().releaseWiFiLock(CalibrationWiFiLock);
    wifiPowerManager().recordActivity();  // normal 90 s Wi-Fi timeout from here, not an immediate switch-off
    applyQueuedModel();
    UpdateThresholdsWithLeadResistance(0.0);
    SetWiretestMode(false);
    LedPanel->SetBlinkColor(AverageLeadResistance > 0.0f ? LedPanel->m_Blue : DefaultBlinkColor);
    ledPanel->ClearAll();
    ledPanel->myShow();
    ledPanel->RestartBlink();
    currentState = Waiting;
    restartSleepGrace();
    Display.setMode("Waiting");
    Display.showMode();
}

void Tester::handleWaitingState() {
    // Capture all 15 measurements once at the beginning
    Capture_.captureAll(currentMeasurements_);

    if (ReelMode) {
        if (ShowingShape != SHAPE_R) {
            LedPanel->ClearAll();
            LedPanel->Draw_R(LedPanel->m_Green);
            LedPanel->myShow();
            ShowingShape = SHAPE_R;
        }
        esp_task_wdt_reset();
        // Also leave when the mode is switched off in the settings while armed
        if (!EnableReelMode || currentMeasurements_.get(Terminal::Al, Terminal::Bl) < Ohm_50) {
            currentState = Waiting;
            ShowingShape = SHAPE_NONE;
            LedPanel->ClearAll();
            LedPanel->myShow();
            SetWiretestMode(false);
            vTaskDelay(1000 / portTICK_PERIOD_MS);  // Small delay to prevent watchdog issues
            restartSleepGrace();
        }

    } else {
        ledPanel->Blink();
#ifndef DOTHETRICK
        if (LowPowerMode) {
            if (!wifiPowerManager().getSecondsUntilTimeout() && (StartForLowPower < millis())) {
                if (!ledPanel->GetBlinkState()) {
                    LedPanel->ClearAll();
                    LedPanel->myShow();
                    if (!enterSleepIfIdle()) {
                        // Something is plugged in: don't sleep, look again later
                        StartForLowPower = millis() + 5000;
                    }
                }
            }
        }
#endif
        // Check for special test modes
        if ((currentMeasurements_.get(Terminal::Cr, Terminal::Cl) < Ohm_20) &&
            (currentMeasurements_.get(Terminal::Ar, Terminal::Al) > 160) &&
            (currentMeasurements_.get(Terminal::Br, Terminal::Bl) > 160)) {
            UpdateThresholdsWithLeadResistance(AverageLeadResistance);
            doLameTest_Top();

            doCommonReturnFromSpecialMode();
            lastSpecialTestExit = millis();
        } else if (currentMeasurements_.get(Terminal::Ar, Terminal::Br) < Ohm_20) {
            ledPanel->ClearAll();
            UpdateThresholdsWithLeadResistance(AverageLeadResistance * 2);
            doFoilTest();

            doCommonReturnFromSpecialMode();
            lastSpecialTestExit = millis();
        } else if (currentMeasurements_.get(Terminal::Br, Terminal::Cr) < Ohm_20) {
            UpdateThresholdsWithLeadResistance(AverageLeadResistance * 2);
            doLameTest();

            doCommonReturnFromSpecialMode();
            lastSpecialTestExit = millis();
        } else if (currentMeasurements_.get(Terminal::Ar, Terminal::Cr) < Ohm_20) {
            currentState = EpeeTesting;
            UpdateThresholdsWithLeadResistance(AverageLeadResistance * 2);
            doEpeeTest();
            doCommonReturnFromSpecialMode();
            lastSpecialTestExit = millis();
        } else if (EnableReelMode && currentMeasurements_.get(Terminal::Al, Terminal::Bl) < Ohm_50) {
            UpdateThresholdsWithLeadResistance(AverageLeadResistance * 2);
            doReelTest();
            restartSleepGrace();
        }

        esp_task_wdt_reset();
    }
    // Check for wire testing mode with delay after special tests
    // Capture 3x3 matrix for wire detection (only right vs left, not right-to-right or left-to-left)
    Capture_.captureMatrix3x3(currentMeasurements_);
    if (MeasurementAnalysis::isWirePluggedIn(currentMeasurements_, Ohm_50)) {
        // Check if enough time has passed since last special test exit
        if (lastSpecialTestExit == 0 || (millis() - lastSpecialTestExit) > WIRE_TEST_DELAY) {
            UpdateThresholdsWithLeadResistance(0.0);

            currentState = WireTesting_1;
            noWireTimeout = NO_WIRES_PLUGGED_IN_TIMEOUT;
            timeToSwitch = WIRE_TEST_1_TIMEOUT;
            ShowingShape = SHAPE_NONE;
            LedPanel->ClearAll();
            LedPanel->myShow();
        }
        // If not enough time has passed, stay in Waiting mode
    }
}

void Tester::handleWireTestingState1() {
    Display.setMode("Wiretest1");
    Display.showWiretesting1();
    Capture_.captureMatrix3x3(currentMeasurements_);

    int brBlValue = currentMeasurements_.get(Terminal::Br, Terminal::Bl);
    int crCLValue = currentMeasurements_.get(Terminal::Cr, Terminal::Cl);
    int arALValue = currentMeasurements_.get(Terminal::Ar, Terminal::Al);
    // printf("Rbb = %.1f\n", ohms(Terminal::Br, Terminal::Bl, brBlValue));
    Display.showWiretesting1Values(ohms(Terminal::Cr, Terminal::Cl, crCLValue),
                                   ohms(Terminal::Ar, Terminal::Al, arALValue),
                                   ohms(Terminal::Br, Terminal::Bl, brBlValue));
    allGood = doQuickCheck();

    if (allGood) {
        timeToSwitch--;
    } else {
        timeToSwitch = WIRE_TEST_1_TIMEOUT;
        if (!MeasurementAnalysis::isWirePluggedIn(currentMeasurements_, ReferenceBroken)) {
            noWireTimeout--;
        } else {
            noWireTimeout = NO_WIRES_PLUGGED_IN_TIMEOUT;
        }
        if (!noWireTimeout) {
            currentState = Waiting;
            restartSleepGrace();
            ShowingShape = SHAPE_NONE;
            Display.setMode("Waiting");
            Display.showMode();
            // SetWiretestMode(false);
        }
    }

    if (!timeToSwitch) {
        // The commented code set all lines to green for the next phase;
        // But this is confusing, because if you go to the next phase with yellow or orange
        // Everything suddenly becomes green
        /*for (int i = 0; i < 5; i += 2) {
            ledPanel->SetLine(i, ledPanel->m_Green);
        }*/
        doQuickCheck(false);  // check one more time (just to keep the correct colors)

        // This is the time to update the threasholds with the lead resistance

        Capture_.captureStraightOnly(currentMeasurements_);
        if (currentMeasurements_.get(Terminal::Cr, Terminal::Cl) < WireOneOhm[0] &&
            currentMeasurements_.get(Terminal::Ar, Terminal::Al) < WireOneOhm[1] &&
            currentMeasurements_.get(Terminal::Br, Terminal::Bl) < WireOneOhm[2]) {
            AverageLeadResistance = 0.0f;

            Terminal straightTerminals[3] = {Terminal::Cr, Terminal::Ar, Terminal::Br};
            Terminal leftTerminals[3] = {Terminal::Cl, Terminal::Al, Terminal::Bl};

            for (int i = 0; i < 3; i++) {
                Terminal rightTerm = straightTerminals[i];
                Terminal leftTerm = leftTerminals[i];
                int measurementValue = currentMeasurements_.get(rightTerm, leftTerm);
                leadresistances[i] = ohms(rightTerm, leftTerm, measurementValue);

                AverageLeadResistance += leadresistances[i];
                // printf("Resistance lead[%d] = %.2f Ohm\n", i, leadresistances[i]);
                // fflush(stdout);                 // Force flush
                vTaskDelay(pdMS_TO_TICKS(10));  // Small delay
            }
            if (AverageLeadResistance > 0.0f) {
                AverageLeadResistance /= 3.0f;
            } else {
                AverageLeadResistance = 0.0f;
            }
            // printf("Average lead resistance = %f & setting blue\n", AverageLeadResistance);
            LedPanel->SetBlinkColor(LedPanel->m_Blue);
        }
        ledPanel->myShow();
        esp_task_wdt_reset();
        vTaskDelay(LOOP_DELAY_IN_WIRETESTING1 / portTICK_PERIOD_MS);
        esp_task_wdt_reset();
        currentState = WireTesting_2;
    }
}

// Wiretesting2 is only looking for breaks. Resistances have been checked in phase 1
// So I'm using a relatively high and fixed value
void Tester::handleWireTestingState2() {
    Display.setMode("Wiretest2");
    Display.showWiretesting1();
    // Display.showMode();
    //  Initial capture to check if wires are still plugged in
    Capture_.captureStraightOnly(currentMeasurements_);
    int brBlValue = currentMeasurements_.get(Terminal::Br, Terminal::Bl);
    int crCLValue = currentMeasurements_.get(Terminal::Cr, Terminal::Cl);
    int arALValue = currentMeasurements_.get(Terminal::Ar, Terminal::Al);
    int AvAA = 0;
    int AvBB = 0;
    int AvCC = 0;

    while (MeasurementAnalysis::isWirePluggedIn(currentMeasurements_, ReferenceBroken)) {
        // Tight loop: capture AND test on every iteration, but keep them separate
        for (int i = 100000; i > 0; i--) {
            esp_task_wdt_reset();
            brBlValue = currentMeasurements_.get(Terminal::Br, Terminal::Bl);
            crCLValue = currentMeasurements_.get(Terminal::Cr, Terminal::Cl);
            arALValue = currentMeasurements_.get(Terminal::Ar, Terminal::Al);
            AvAA += arALValue;
            AvBB += brBlValue;
            AvCC += crCLValue;
            if (!(i % 10)) {
                Display.showWiretesting1Values(ohms(Terminal::Cr, Terminal::Cl, AvCC / 10.0f),
                                               ohms(Terminal::Ar, Terminal::Al, AvAA / 10.0f),
                                               ohms(Terminal::Br, Terminal::Bl, AvBB / 10.0f));
                AvAA = 0;
                AvBB = 0;
                AvCC = 0;
            }
            // Step 1: Test the captured data (pure logic)
            if (crCLValue >= ReferenceBroken || arALValue >= ReferenceBroken || brBlValue >= ReferenceBroken) {
                break;
            }
            // Step 2: Capture (separate function call) This has to be here to make sure we exit immediately if one of
            // the wires is set to red
            Capture_.captureStraightOnly(currentMeasurements_);
        }

        ledPanel->ClearAll();
        ledPanel->myShow();
        brBlValue = currentMeasurements_.get(Terminal::Br, Terminal::Bl);
        crCLValue = currentMeasurements_.get(Terminal::Cr, Terminal::Cl);
        arALValue = currentMeasurements_.get(Terminal::Ar, Terminal::Al);
        Display.showWiretesting1Values(ohms(Terminal::Cr, Terminal::Cl, crCLValue),
                                       ohms(Terminal::Ar, Terminal::Al, arALValue),
                                       ohms(Terminal::Br, Terminal::Bl, brBlValue));

        allGood &= animateSingleWire(currentMeasurements_, Terminal::Cr);
        allGood &= animateSingleWire(currentMeasurements_, Terminal::Ar);
        allGood &= animateSingleWire(currentMeasurements_, Terminal::Br);

        esp_task_wdt_reset();
        vTaskDelay(1500 / portTICK_PERIOD_MS);
        esp_task_wdt_reset();
        ledPanel->ClearAll();
        ledPanel->myShow();
        Capture_.captureMatrix3x3(currentMeasurements_);
        doQuickCheck(false);  // check one more time (just to keep the correct colors)
    }
    timeToSwitch = WIRE_TEST_1_TIMEOUT;
    ledPanel->ClearAll();
    ledPanel->myShow();
    ShowingShape = SHAPE_NONE;
    currentState = Waiting;
    restartSleepGrace();
    SetWiretestMode(false);
    Display.setMode("Waiting");
    Display.showMode();
}

void Tester::doCommonReturnFromSpecialMode() {
    currentState = Waiting;
    SetWiretestMode(false);
    esp_task_wdt_reset();
    ledPanel->ClearAll();
    ledPanel->RestartBlink();

    for (int i = 0; i < 25; i++) {
        vTaskDelay(50 / portTICK_PERIOD_MS);
        ledPanel->Blink();
        esp_task_wdt_reset();
    }

    ledPanel->ClearAll();
    Capture_.captureMatrix3x3(currentMeasurements_);
    restartSleepGrace();
}

// Enter deep sleep unless something is connected. Does not return when it sleeps.
bool Tester::enterSleepIfIdle() {
#if HARDWARE_REV == 3
    if (!isIdleForWakeOnConnect()) {
        return false;
    }
    rtc.store("LeadR", AverageLeadResistance);
    Display.sleep();
    enterWakeOnConnectSleep(myDeepSleepHandler);
#else
    rtc.store("LeadR", AverageLeadResistance);
    Display.sleep();
    myDeepSleepHandler.enableTimerWakeup(2000000);
    myDeepSleepHandler.enterDeepSleep();
#endif
    return false;
}

// Call on entering epee, foil or lame mode: that mode was entered because
// something is connected.
void Tester::startSpecialModeSleepTimer() {
    lastConnectionSeen_ = millis();
    lastSpecialModeCheck_ = millis();
}

// Call from the epee/foil/lame loops. About once a second, check all 15 terminal
// pairs; after SpecialModeSleepTimeout seconds with nothing connected, sleep.
void Tester::checkSpecialModeSleep() {
    if (!LowPowerMode || SpecialModeSleepTimeout <= 0) {
        return;
    }
    unsigned long now = millis();
    if (now - lastSpecialModeCheck_ < 1000) {
        return;
    }
    lastSpecialModeCheck_ = now;

    MeasurementSet all;
    Capture_.captureAll(all);
    for (size_t i = 0; i < all.count(); i++) {
        // abs(): some pairs (e.g. Al-Cl) are captured with reversed polarity and
        // read about -3100 mV when open
        if (abs(all[i].millivolts()) < WireConnectedThreshold) {
            lastConnectionSeen_ = now;
            return;
        }
    }
    if (now - lastConnectionSeen_ < (unsigned long)SpecialModeSleepTimeout * 1000UL) {
        return;
    }
    if (wifiPowerManager().getSecondsUntilTimeout()) {
        return;  // WiFi still in use
    }
    LedPanel->ClearAll();
    LedPanel->myShow();
    Display.clear();
    if (!enterSleepIfIdle()) {
        // The wake pins see a connection after all: stay in the mode, start over
        lastConnectionSeen_ = now;
        ShowingShape = SHAPE_NONE;  // force the mode loop to redraw
    }
}

void Tester::restartSleepGrace() {
    // Only after a wake from deep sleep; after a power cycle the 90 s start-up
    // delay and the WiFi timeout decide when to sleep
    if (esp_sleep_get_wakeup_cause() != ESP_SLEEP_WAKEUP_UNDEFINED) {
        StartForLowPower = millis() + SLEEP_GRACE_AFTER_WAKE_MS;
    }
}

bool Tester::delayAndTestWirePluggedIn(long delay) {
    long returnTime = millis() + delay;
    while (millis() < returnTime) {
        esp_task_wdt_reset();
        Capture_.captureMatrix3x3(currentMeasurements_);
        if (MeasurementAnalysis::isWirePluggedIn(currentMeasurements_)) {
            return true;
        }
    }
    return false;
}

bool Tester::delayAndTestWirePluggedInFoil(long delay) {
    long returnTime = millis() + delay;
    while (millis() < returnTime) {
        esp_task_wdt_reset();
        Capture_.captureMatrix3x3(currentMeasurements_);
        if (MeasurementAnalysis::isWirePluggedInFoil(currentMeasurements_)) {
            return true;
        }
        // While waiting, show the current Ar-Cl resistance value (or 9999.99 if unavailable)
        int raw = currentMeasurements_.get(Terminal::Ar, Terminal::Cl);
        if (raw == INT32_MAX) {
            raw = Capture_.captureSingle(Terminal::Ar, Terminal::Cl);
        }
        if (raw != INT32_MAX) {
            float r = ohms(Terminal::Ar, Terminal::Cl, raw);
            Display.showSingleValue(r);
        } else {
            Display.showSingleValue(9999.99);
        }
        vTaskDelay(10 / portTICK_PERIOD_MS);
    }
    return false;
}

bool Tester::delayAndTestWirePluggedInEpee(long delay) {
    long returnTime = millis() + delay;
    while (millis() < returnTime) {
        esp_task_wdt_reset();
        Capture_.captureMatrix3x3(currentMeasurements_);
        if (MeasurementAnalysis::isWirePluggedInEpee(currentMeasurements_)) {
            return true;
        }
    }
    return false;
}
bool Tester::delayAndTestWirePluggedInEpeeAndShowConnectionValue(long delay, Terminal Tfrom, Terminal Tto) {
    long returnTime = millis() + delay;
    while (millis() < returnTime) {
        esp_task_wdt_reset();
        Capture_.captureMatrix3x3(currentMeasurements_);
        if (MeasurementAnalysis::isWirePluggedInEpee(currentMeasurements_)) {
            return true;
        }
        // Try to use the cached 3x3 measurement first. If the pair is not present
        // in the matrix (e.g. both terminals on the same side), fall back to
        // performing a single capture for that pair.
        int raw = currentMeasurements_.get(Tfrom, Tto);
        if (raw == INT32_MAX) {
            raw = Capture_.captureSingle(Tfrom, Tto);
        }
        if (raw != INT32_MAX) {
            float r = ohms(Tfrom, Tto, raw);
            Display.showSingleValue(r);
        } else {
            Display.showSingleValue(9999.99);  // indicate invalid/unavailable
        }

        float r = ohms(Tfrom, Tto, raw);
        Display.showSingleValue(r);
    }
    return false;
}

bool Tester::delayAndTestWirePluggedInLameTestTop(long delay) {
    long returnTime = millis() + delay;
    while (millis() < returnTime) {
        esp_task_wdt_reset();
        Capture_.captureMatrix3x3(currentMeasurements_);
        if (MeasurementAnalysis::isWirePluggedInLameTop(currentMeasurements_)) {
            return true;
        }
    }
    return false;
}

void Tester::doReelTest() {
    ShowingShape = SHAPE_R;
    LedPanel->ClearAll();
    LedPanel->Draw_R(LedPanel->m_Green);
    LedPanel->myShow();
    SetWiretestMode(true);

    // Initial capture before entering loop
    Capture_.captureMatrix3x3(currentMeasurements_);

    while (EnableReelMode && !MeasurementAnalysis::isWirePluggedInEpee(currentMeasurements_, ReferenceBroken)) {
        esp_task_wdt_reset();
        // Refresh measurements for next iteration
        Capture_.captureMatrix3x3(currentMeasurements_);
    }
    if (!EnableReelMode) {
        SetWiretestMode(false);  // switched off in the settings while waiting for a reel
    }
    ShowingShape = SHAPE_NONE;
    LedPanel->ClearAll();
    LedPanel->myShow();
}

void Tester::doEpeeTest() {
    int BrCl;
    int arCr, arCl, arBr, brCr;  // Declare all loop variables at function scope
    uint32_t tempColor;
    ShowingShape = SHAPE_NONE;
    LedPanel->ClearAll();

    // Initial capture before entering loop
    Capture_.captureMatrix3x3(currentMeasurements_);
    Display.setMode("Epee");
    Display.showMode();
    startSpecialModeSleepTimer();

    while (!MeasurementAnalysis::isWirePluggedInEpee(currentMeasurements_)) {
        esp_task_wdt_reset();
        BrCl = Capture_.measureBrCl();
        if (BrCl < ProbeConnectedThreshold) {
            // We're in Probe mode
            if (SHAPE_P != ShowingShape) {
                LedPanel->ClearAll();
                ShowingShape = SHAPE_P;
                Display.initForSingleValue("probe");
            }
            if (BrCl < Probe_Green) {
                LedPanel->Draw_P(LedPanel->m_Green);
            } else if (BrCl < Probe_Yellow) {
                LedPanel->Draw_P(LedPanel->m_Yellow);
            } else if (BrCl < Probe_Orange) {
                LedPanel->Draw_P(LedPanel->m_Orange);
            } else {
                LedPanel->Draw_P(LedPanel->m_Red);
            }
            LedPanel->myShow();
            float r = ohms(Terminal::Br, Terminal::Cl, BrCl);
            Display.showSingleValue(r);
            /*if (delayAndTestWirePluggedInFoil(100)) {
                break;
            }*/
            vTaskDelay(100 / portTICK_PERIOD_MS);
            goto loop_end;
        }

        arCr = Capture_.measureArCr();
        arCl = Capture_.measureArCl();
        arBr = Capture_.measureArBr();
        brCr = Capture_.measureBrCr();

        // Case 1: Both ArBr and BrCr > ShortDetectThreshold, ArCl > EpeeTipContactThreshold
        // No shorts → measuring return wire (tip not touching probe)
        if ((arBr > EpeeLeak && brCr > EpeeLeak) && arCl > EpeeTipContactThreshold) {
            // Show color based on ArCr

            // printf("Rac = %.1f\n", ohms(Terminal::Ar, Terminal::Cr, arCr));
            if (arCr < EpeeLoop_Green) {
                tempColor = LedPanel->m_Green;
            } else if (arCr < EpeeLoop_Yellow) {
                tempColor = LedPanel->m_Yellow;
            } else if (arCr < EpeeLoop_Orange) {
                tempColor = LedPanel->m_Orange;
            } else {
                // Above 600, don't show anything
                if (SHAPE_E != ShowingShape) {
                    LedPanel->ClearAll();
                    ShowingShape = SHAPE_E;
                    LedPanel->Draw_E(LedPanel->m_White);
                }
                goto loop_end;
            }
            if (SHAPE_SQUARE != ShowingShape) {
                LedPanel->ClearAll();
                ShowingShape = SHAPE_SQUARE;
                Display.initForSingleValue("a-b");
            }
            LedPanel->SetInner9(tempColor);
            LedPanel->myShow();
            float r = ohms(Terminal::Ar, Terminal::Cr, arCr);
            Display.showSingleValue(r);
            if (delayAndTestWirePluggedInEpeeAndShowConnectionValue(1000, Terminal::Ar, Terminal::Cr)) {
                break;
            }
            // LedPanel->ClearAll();
            LedPanel->myShow();
        }
        // Case 2: Both ArBr and BrCr > ShortDetectThreshold, ArCl < EpeeTipContactThreshold
        // No shorts → tip touching probe, measuring single wire
        else if ((arBr > EpeeLeak && brCr > EpeeLeak) && arCl < EpeeTipContactThreshold) {
            if (arCl < EpeeTip_Green) {
                tempColor = LedPanel->m_Green;
            } else if (arCl < EpeeTip_Yellow) {
                tempColor = LedPanel->m_Yellow;
            } else if (arCl < EpeeTip_Orange) {
                tempColor = LedPanel->m_Orange;
            } else {
                if (SHAPE_E != ShowingShape) {
                    LedPanel->ClearAll();
                    ShowingShape = SHAPE_E;
                    LedPanel->Draw_E(LedPanel->m_White);
                }
                goto loop_end;
            }
            if (SHAPE_SQUARE != ShowingShape) {
                LedPanel->ClearAll();
                ShowingShape = SHAPE_SQUARE;
                Display.initForSingleValue("tip");
            }
            LedPanel->SetInner9(tempColor);
            LedPanel->myShow();
            float r = ohms(Terminal::Ar, Terminal::Cl, arCl);
            Display.showSingleValue(r);
            if (delayAndTestWirePluggedInEpeeAndShowConnectionValue(1000, Terminal::Ar, Terminal::Cl)) {
                break;
            }
            // LedPanel->ClearAll();

            LedPanel->myShow();
        }
        // Case 3: ArBr < ShortDetectThreshold or BrCr < ShortDetectThreshold (unwanted short)
        else if (arBr < EpeeLeak || brCr < EpeeLeak) {
            LedPanel->ClearAll();
            Display.initForSingleValue("mass");
            if (arBr < EpeeLeak) {
                float r = ohms(Terminal::Ar, Terminal::Br, arBr);
                Display.showSingleValue(r);
                LedPanel->AnimateArBrConnection();
            }
            if (brCr < EpeeLeak) {
                float r = ohms(Terminal::Br, Terminal::Cr, brCr);
                Display.showSingleValue(r);
                LedPanel->AnimateBrCrConnection();
            }
        }
        // All other cases: draw white E
        else {
            if (SHAPE_E != ShowingShape) {
                LedPanel->ClearAll();
                ShowingShape = SHAPE_E;
                LedPanel->Draw_E(LedPanel->m_White);
                Display.initForSingleValue("a-b");
                Display.showSingleValue(9999.99);
            }
        }

        esp_task_wdt_reset();
    loop_end:
        checkSpecialModeSleep();
        // Refresh measurements for next iteration
        Capture_.captureMatrix3x3(currentMeasurements_);
    }
    LedPanel->ClearAll();
    LedPanel->myShow();
    Display.clear();
}

void Tester::doFoilTest() {
    int BrCl;
    int arBr;  // Declare loop variable at function scope
    int ArCl;
    float r;
    // Initial capture before entering loop
    Capture_.captureMatrix3x3(currentMeasurements_);
    Display.setMode("Foil");
    Display.showMode();
    startSpecialModeSleepTimer();

    while (!MeasurementAnalysis::isWirePluggedInFoil(currentMeasurements_)) {
        esp_task_wdt_reset();
        LedPanel->myShow();
        if (currentMeasurements_.get(Terminal::Cr, Terminal::Cl) < ShortDetectThreshold) {
            doFoilLeakTest();
        }
        BrCl = Capture_.measureBrCl();
        if (BrCl < ProbeConnectedThreshold) {  // Probe Mode
            if (SHAPE_P != ShowingShape) {
                LedPanel->ClearAll();
                ShowingShape = SHAPE_P;
                Display.initForSingleValue("probe");
            }
            if (BrCl < Probe_Green) {
                LedPanel->Draw_P(LedPanel->m_Green);
            } else if (BrCl < Probe_Yellow) {
                LedPanel->Draw_P(LedPanel->m_Yellow);
            } else if (BrCl < Probe_Orange) {
                LedPanel->Draw_P(LedPanel->m_Orange);
            } else {
                LedPanel->Draw_P(LedPanel->m_Red);
            }
            r = ohms(Terminal::Br, Terminal::Cl, BrCl);
            Display.showSingleValue(r);
            LedPanel->myShow();
            /*if (delayAndTestWirePluggedInFoil(100)) {
                break;
            }*/
            vTaskDelay(100 / portTICK_PERIOD_MS);
            goto loop_end;
        }

        arBr = Capture_.measureArBr();
        if (SHAPE_F != ShowingShape) {
            if (arBr < WireConnectedThreshold) {
                LedPanel->ClearAll();
                ShowingShape = SHAPE_F;
                Display.initForSingleValue("a_b");
            }
        }
        r = ohms(Terminal::Ar, Terminal::Br, arBr);

        if (arBr < FoilLoop_Green) {
            LedPanel->Draw_F(LedPanel->m_Green);
            Display.showSingleValue(r);
            goto loop_end;
        } else if (arBr < FoilLoop_Yellow) {
            LedPanel->Draw_F(LedPanel->m_Yellow);
            Display.showSingleValue(r);
            goto loop_end;
        } else if (arBr < FoilLoop_Orange) {
            LedPanel->Draw_F(LedPanel->m_Orange);
            Display.showSingleValue(r);
            goto loop_end;
        } else if (arBr < FoilLeakThreshold) {
            LedPanel->Draw_F(LedPanel->m_Blue);
            Display.showSingleValue(r);
            goto loop_end;
        } else {
            // Debounce: measureArBr() > FoilLeakThreshold must be true for 10ms
            bool debounced = true;
            unsigned long start = millis();
            Display.showSingleValue(r);
            while (millis() - start < 13) {
                esp_task_wdt_reset();
                if (Capture_.measureArBr() <= FoilLeakThreshold) {
                    debounced = false;
                    break;
                }
                taskYIELD();
            }

            if (!debounced) {
                goto loop_end;
            }

            // Debouncing succeeded: show inner lights based on ArCl
            if (SHAPE_SQUARE != ShowingShape) {
                LedPanel->ClearAll();
                ShowingShape = SHAPE_SQUARE;
                Display.initForSingleValue("tip");
            }
            ArCl = Capture_.measureArCl();
            if (ArCl < FoilTip_Green) {
                LedPanel->SetInner9(LedPanel->m_Green);
            } else if (ArCl < FoilTip_Yellow) {
                LedPanel->SetInner9(LedPanel->m_Yellow);
            } else if (ArCl < FoilTip_Orange) {
                LedPanel->SetInner9(LedPanel->m_Orange);
            } else {
                LedPanel->SetInner9(LedPanel->m_White);
            }

            r = ohms(Terminal::Ar, Terminal::Cl, ArCl);
            Display.showSingleValue(r);
            LedPanel->myShow();

            if (delayAndTestWirePluggedInFoil(1000)) {
                if (currentMeasurements_.get(Terminal::Cr, Terminal::Cl) < FoilLeakThreshold) {
                    doFoilLeakTest();
                } else {
                    break;
                }
            }
            if (Capture_.measureArBr() <= FoilLeakThreshold) {
                LedPanel->ClearAll();
                LedPanel->myShow();
            }
        }
    loop_end:
        checkSpecialModeSleep();
        // Refresh measurements for next iteration
        Capture_.captureMatrix3x3(currentMeasurements_);
    }

    LedPanel->ClearAll();
    LedPanel->myShow();
    Display.clear();
}

void Tester::doFoilLeakTest() {
    if (!EnableFoilLeakTest) {
        return;
    }
    int ArBr;
    float r;
    Display.initForSingleValue("leak");
    if (SHAPE_GND != ShowingShape) {
        LedPanel->ClearAll();
        ShowingShape = SHAPE_GND;
        // Display.initForSingleValue("tip");
    }
    LedPanel->Draw_GND(LedPanel->m_Green);
    LedPanel->myShow();

    vTaskDelay(500 / portTICK_PERIOD_MS);
    while (true) {
        esp_task_wdt_reset();

        ArBr = Capture_.measureArBr();
        r = ohms(Terminal::Ar, Terminal::Br, ArBr);
        Display.showSingleValue(r);
        if (ArBr < FoilLeakThreshold) {
            LedPanel->ClearAll();
            LedPanel->SetInner9(LedPanel->m_Blue);
            LedPanel->myShow();
            vTaskDelay(1000 / portTICK_PERIOD_MS);
            // Ar-Br (the foil cord's own bridge) can stay shorted indefinitely, so bound this wait
            unsigned long leakTimeoutStart = millis();
            while (ArBr < FoilLeakThreshold && (millis() - leakTimeoutStart) < 500) {
                esp_task_wdt_reset();
                ArBr = Capture_.measureArBr();
                r = ohms(Terminal::Ar, Terminal::Br, ArBr);
                Display.showSingleValue(r);
            }

            LedPanel->ClearAll();
            LedPanel->Draw_GND(LedPanel->m_Green);
            LedPanel->myShow();
        }
        if (Capture_.measureCrCl() < FoilLeakThreshold)
            break;
        checkSpecialModeSleep();
        vTaskDelay(1 / portTICK_PERIOD_MS);
    }
}

// Display functions moved to DisplayManager
void Tester::doLameTest() {
    // Your existing DoLameTest code
    Display.setMode("Lame");
    Display.showMode();
    bool bShowingRed = false;
    Display.initForSingleValue("lame");

    // Initial capture before entering loop
    Capture_.captureMatrix3x3(currentMeasurements_);
    startSpecialModeSleepTimer();
    float r = 0.0f;
    while (!MeasurementAnalysis::isWirePluggedIn(currentMeasurements_)) {
        esp_task_wdt_reset();

        if (int raw = Capture_.measureBrCr(); raw < LameBottom_Green) {
            LedPanel->DrawDiamond(LedPanel->m_Green);
            bShowingRed = false;
            r = ohms(Terminal::Br, Terminal::Cr, raw);
            Display.showSingleValue(r);
            while (debouncedCondition(
                [this]() {
                    int temp = Capture_.measureBrCr();
                    float r = ohms(Terminal::Br, Terminal::Cr, temp);
                    Display.showSingleValue(r);
                    return temp < LameBottom_Green;
                },
                10));
        } else {
            if (int raw = Capture_.measureBrCr(); raw < LameBottom_Yellow) {
                LedPanel->DrawDiamond(LedPanel->m_Yellow);
                bShowingRed = false;
                r = ohms(Terminal::Br, Terminal::Cr, raw);
                Display.showSingleValue(r);
                while (debouncedCondition(
                    [this]() {
                        int temp = Capture_.measureBrCr();
                        float r = ohms(Terminal::Br, Terminal::Cr, temp);
                        Display.showSingleValue(r);
                        return ((temp < LameBottom_Yellow) && (temp >= LameBottom_Green));
                    },
                    10));
            } else {
                if (int raw = Capture_.measureBrCr(); raw < LameBottom_Orange) {
                    LedPanel->DrawDiamond(LedPanel->m_Orange);
                    bShowingRed = false;
                    r = ohms(Terminal::Br, Terminal::Cr, raw);
                    Display.showSingleValue(r);
                    while (debouncedCondition(
                        [this]() {
                            int temp = Capture_.measureBrCr();
                            float r = ohms(Terminal::Br, Terminal::Cr, temp);
                            Display.showSingleValue(r);
                            return ((temp < LameBottom_Orange) && (temp >= LameBottom_Yellow));
                        },
                        10));
                } else {
                    // Do Red stuff
                    bShowingRed = true;
                    r = ohms(Terminal::Br, Terminal::Cr, raw);
                    Display.showSingleValue(r);
                    LedPanel->DrawDiamond(LedPanel->m_Red);
                    LedPanel->setBuzz(true);
                    if (delayAndTestWirePluggedIn(250)) {
                        LedPanel->setBuzz(false);
                        break;
                    }
                    LedPanel->setBuzz(false);
                }
            }
        }

        esp_task_wdt_reset();
        checkSpecialModeSleep();
        // Refresh measurements for next iteration
        Capture_.captureMatrix3x3(currentMeasurements_);
    }
    LedPanel->ClearAll();
    LedPanel->myShow();
    Display.clear();
}

bool Tester::DebounceTest(int LowBound, int HighBound) {
    Capture_.captureMatrix3x3(currentMeasurements_);
    if (MeasurementAnalysis::isWirePluggedInLameTop(currentMeasurements_)) {
        return false;
    }
    int crCl = currentMeasurements_.get(Terminal::Cr, Terminal::Cl);
    float r = ohms(Terminal::Cr, Terminal::Cl, crCl);
    Display.showSingleValue(r);
    return ((crCl >= LowBound) && (crCl < HighBound));
}

void Tester::doLameTest_Top() {
    // Your existing DoLameTest code
    Display.setMode("Lame");
    Display.showMode();
    bool bShowingRed = false;
    Display.initForSingleValue("lame");
    // Initial capture before entering loop
    Capture_.captureMatrix3x3(currentMeasurements_);
    startSpecialModeSleepTimer();

    while (!MeasurementAnalysis::isWirePluggedInLameTop(currentMeasurements_)) {
        esp_task_wdt_reset();
        if (int raw = Capture_.measureCrCl(); raw < LameTop_Green) {
            LedPanel->DrawDiamond(LedPanel->m_Green);
            bShowingRed = false;
            float r = ohms(Terminal::Cr, Terminal::Cl, raw);
            Display.showSingleValue(r);
            while (debouncedCondition([this]() { return DebounceTest(0, LameTop_Green); }, 10));
        } else {
            if (int raw = Capture_.measureCrCl(); raw < LameTop_Yellow) {
                LedPanel->DrawDiamond(LedPanel->m_Yellow);
                bShowingRed = false;
                float r = ohms(Terminal::Cr, Terminal::Cl, raw);
                Display.showSingleValue(r);
                while (debouncedCondition([this]() { return DebounceTest(LameTop_Green, LameTop_Yellow); }, 10));
            } else {
                if (int raw = Capture_.measureCrCl(); raw < LameTop_Orange) {
                    LedPanel->DrawDiamond(LedPanel->m_Orange);
                    bShowingRed = false;
                    float r = ohms(Terminal::Cr, Terminal::Cl, raw);
                    Display.showSingleValue(r);
                    while (debouncedCondition([this]() { return DebounceTest(LameTop_Yellow, LameTop_Orange); }, 10));
                } else {
                    LedPanel->DrawDiamond(LedPanel->m_Red);
                    bShowingRed = true;
                    LedPanel->setBuzz(true);
                    float r = ohms(Terminal::Cr, Terminal::Cl, raw);
                    Display.showSingleValue(r);
                    if (delayAndTestWirePluggedInLameTestTop(250)) {
                        LedPanel->setBuzz(false);
                        break;
                    }
                    LedPanel->setBuzz(true);
                }
            }
        }

        esp_task_wdt_reset();
        checkSpecialModeSleep();
        // Refresh measurements for next iteration
        Capture_.captureMatrix3x3(currentMeasurements_);
    }
    LedPanel->ClearAll();
    LedPanel->myShow();
    Display.clear();
}

void Tester::SetWiretestMode(bool Reelmode) {
    if (Reelmode) {
        ReferenceBroken = Reel_Broken;
        for (int w = 0; w < 3; w++) {
            ReferenceGreen[w] = Reel_Green[w];
            ReferenceYellow[w] = Reel_Yellow[w];
        }
        ReferenceOrange = Reel_Broken;
        ReferenceShort = 300;
        ReelMode = true;
    } else {
        ReferenceBroken = Bodycord_Broken;
        for (int w = 0; w < 3; w++) {
            ReferenceGreen[w] = Bodycord_Green[w];
            ReferenceYellow[w] = Bodycord_Yellow[w];
        }
        ReferenceOrange = Bodycord_Broken;
        ReferenceShort = 160;
        ReelMode = false;
    }
}

bool Tester::animateSingleWire(const MeasurementSet& measurements, Terminal terminal) {
    // Map terminal to LED panel index for animations
    int wireIndex = (terminal == Terminal::Cr) ? 0 : (terminal == Terminal::Ar) ? 1 : 2;

    // Define the other two terminals for cross-connection checks
    Terminal otherTerminals[2];
    if (terminal == Terminal::Cr) {
        otherTerminals[0] = Terminal::Ar;
        otherTerminals[1] = Terminal::Br;
    } else if (terminal == Terminal::Ar) {
        otherTerminals[0] = Terminal::Br;
        otherTerminals[1] = Terminal::Cr;
    } else {  // Terminal::Br
        otherTerminals[0] = Terminal::Cr;
        otherTerminals[1] = Terminal::Ar;
    }

    // Map other terminals to their LED indices
    int otherIndex1 = (otherTerminals[0] == Terminal::Cr) ? 0 : (otherTerminals[0] == Terminal::Ar) ? 1 : 2;
    int otherIndex2 = (otherTerminals[1] == Terminal::Cr) ? 0 : (otherTerminals[1] == Terminal::Ar) ? 1 : 2;

    // Get straight-through measurement (right terminal to its corresponding left terminal)
    Terminal leftTerminal = (terminal == Terminal::Cr)   ? Terminal::Cl
                            : (terminal == Terminal::Ar) ? Terminal::Al
                                                         : Terminal::Bl;
    int straightMeasurement = measurements.get(terminal, leftTerminal);

    // Get cross-connection measurements
    Terminal leftOther1 = (otherTerminals[0] == Terminal::Cr)   ? Terminal::Cl
                          : (otherTerminals[0] == Terminal::Ar) ? Terminal::Al
                                                                : Terminal::Bl;
    Terminal leftOther2 = (otherTerminals[1] == Terminal::Cr)   ? Terminal::Cl
                          : (otherTerminals[1] == Terminal::Ar) ? Terminal::Al
                                                                : Terminal::Bl;
    int crossMeasurement1 = measurements.get(terminal, leftOther1);
    int crossMeasurement2 = measurements.get(terminal, leftOther2);

    bool bOK = false;
    if (straightMeasurement < ReferenceBroken) {
        if ((crossMeasurement1 > 200) && (crossMeasurement2 > 200)) {
            // OK - good straight connection, no cross-shorts
            int level = 2;
            if (straightMeasurement <= ReferenceYellow[wireIndex])
                level = 1;
            if (straightMeasurement <= ReferenceGreen[wireIndex])
                level = 0;

            LedPanel->AnimateGoodConnection(wireIndex, level);
            bOK = true;
        } else {
            // Short detected
            if (crossMeasurement1 < ReferenceShort)
                LedPanel->AnimateShort(wireIndex, otherIndex1);
            else if (crossMeasurement2 < ReferenceShort)
                LedPanel->AnimateShort(wireIndex, otherIndex2);
        }
    } else {
        if ((crossMeasurement1 > ReferenceShort) && (crossMeasurement2 > ReferenceShort)) {
            // Simply broken - high resistance on all connections
            LedPanel->AnimateBrokenConnection(wireIndex);
        } else {
            // Wrong connection - broken straight but has cross connection
            if (crossMeasurement1 < ReferenceShort)
                LedPanel->AnimateWrongConnection(wireIndex, otherIndex1);
            if (crossMeasurement2 < ReferenceShort)
                LedPanel->AnimateWrongConnection(wireIndex, otherIndex2);
        }
    }
    return bOK;
}

bool Tester::doQuickCheck(bool bClearAtTheEnd) {
    // Check all three wire connections using already-captured measurements
    bool bAllGood = true;

    bAllGood &= animateSingleWire(currentMeasurements_, Terminal::Cr);
    bAllGood &= animateSingleWire(currentMeasurements_, Terminal::Ar);
    bAllGood &= animateSingleWire(currentMeasurements_, Terminal::Br);

    esp_task_wdt_reset();
    vTaskDelay(500 / portTICK_PERIOD_MS);
    esp_task_wdt_reset();
    if (bClearAtTheEnd) {
        ledPanel->ClearAll();
        esp_task_wdt_reset();
    }

    vTaskDelay(300 / portTICK_PERIOD_MS);
    esp_task_wdt_reset();
    return bAllGood;
}

// Public getter methods
State_t Tester::getState() const { return currentState; }

void Tester::setState(State_t newState) { currentState = newState; }

bool Tester::isAllGood() const { return allGood; }

void Tester::startCalibration() { DoCalibration = true; }

void Tester::stopCalibration() { DoCalibration = false; }

// void Tester::setReferenceValues(int* refs) { myRefs_Ohm = refs; }
// int* Tester::getReferenceValues() const { return myRefs_Ohm; }

bool Tester::debouncedCondition(std::function<bool()> condition, int debounceMs) {
    unsigned long falseStartTime = 0;
    bool timing = false;

    while (true) {
        bool currentCondition = condition();

        if (currentCondition) {
            // Condition is true, reset timer and keep waiting
            timing = false;
            falseStartTime = 0;
        } else {
            if (!timing) {
                // Just became false, start timing
                falseStartTime = millis();
                timing = true;
            }
            // Check if it's been false long enough
            if (millis() - falseStartTime >= debounceMs) {
                return false;  // Debounced: condition has been false for debounceMs
            }
        }
        esp_task_wdt_reset();
        taskYIELD();
    }
}
