pietwauters/ImprovedTesterAfterGenova/extra_script.py

import os
import subprocess
from datetime import datetime
from SCons.Script import Import

Import("env")


def embed_web_pages():
    """Gzip web/calibrate.html into src/calibrate_html.h, served by the tester at /calibrate.

    Runs on every build; the header is only rewritten when the page changed, so
    an unchanged page does not trigger a recompile.
    """
    import gzip

    project_dir = env["PROJECT_DIR"]
    src = os.path.join(project_dir, "web", "calibrate.html")
    out = os.path.join(project_dir, "src", "calibrate_html.h")
    with open(src, "rb") as f:
        data = gzip.compress(f.read(), compresslevel=9, mtime=0)
    rows = [", ".join("0x%02x" % b for b in data[i:i + 16]) for i in range(0, len(data), 16)]
    text = (
        "// Generated by extra_script.py from web/calibrate.html - do not edit.\n"
        "#pragma once\n\n#include <stddef.h>\n#include <stdint.h>\n\n"
        "static const uint8_t calibrate_html_gz[] = {\n    " + ",\n    ".join(rows) + "\n};\n"
        "static const size_t calibrate_html_gz_len = %d;\n" % len(data)
    )
    old = None
    if os.path.exists(out):
        with open(out) as f:
            old = f.read()
    if text != old:
        with open(out, "w") as f:
            f.write(text)
        print("Embedded web/calibrate.html (%d bytes gzipped)" % len(data))


embed_web_pages()


def write_version_header():
    """APP_VERSION from `git describe`, written to the build dir's version.h on every build.

    A build from a modified working tree also gets the build time, so every test
    binary is identifiable in calibration run records. Rewritten only on change.
    """
    project_dir = env["PROJECT_DIR"]
    try:
        version = subprocess.check_output(["git", "describe", "--tags", "--always", "--dirty"],
                                          cwd=project_dir, stderr=subprocess.DEVNULL).decode().strip()
    except (OSError, subprocess.CalledProcessError):
        version = "unknown"
    if version.endswith("-dirty"):
        version += "+" + datetime.now().strftime("%Y%m%d-%H%M")
    path = os.path.join(env.subst("$BUILD_DIR"), "version.h")
    text = '#pragma once\n#define APP_VERSION "%s"\n' % version
    old = None
    if os.path.exists(path):
        with open(path) as f:
            old = f.read()
    if text != old:
        os.makedirs(os.path.dirname(path), exist_ok=True)
        with open(path, "w") as f:
            f.write(text)
    print("Firmware version: " + version)


write_version_header()

def after_build(source, target, env):
    print("📦 Post-build script running")

    # Directories and filenames
    project_dir = env["PROJECT_DIR"]
    build_dir = os.path.join(project_dir, ".pio", "build", env["PIOENV"])
    ota_dir = os.path.join(project_dir, "OTAbuilds")
    os.makedirs(ota_dir, exist_ok=True)

    # Input files
    app_bin = os.path.join(build_dir, "firmware.bin")
    bootloader_bin = os.path.join(project_dir, "bootloader", "bootloader.bin")
    partition_bin = os.path.join(project_dir, "partition_table", "partition-table.bin")

    # Hardware-revision tag (env name), so OTA binaries are self-labeling and
    # can't be confused between boards.
    hw_tag = env["PIOENV"]

    # Timestamp for filenames
    timestamp = datetime.now().strftime("%Y%m%d-%H%M%S")
    ota_bin_out = os.path.join(ota_dir, f"firmware_{hw_tag}_{timestamp}.bin")
    merged_bin_out = os.path.join(ota_dir, f"merged_firmware_{hw_tag}_{timestamp}.bin")

    print(f"📦 Timestamp: {timestamp}")
    print(f"📄 App binary: {app_bin}")
    print(f"📄 Bootloader: {bootloader_bin}")
    print(f"📄 Partition:  {partition_bin}")

    # Verify inputs exist
    if not all(os.path.exists(p) for p in [app_bin, bootloader_bin, partition_bin]):
        print("❌ Required binary not found. Skipping merge.")
        return

    # Copy OTA binary with timestamp
    try:
        import shutil
        shutil.copy2(app_bin, ota_bin_out)
        print(f"✅ OTA firmware copied to {ota_bin_out}")
    except Exception as e:
        print(f"❌ Error copying OTA binary: {e}")
        return

    # Merge binary using esptool.py
    try:
        subprocess.run([
            "esptool.py",
            "--chip", "esp32",
            "merge_bin",
            "-o", merged_bin_out,
            "0x1000", bootloader_bin,
            "0x8000", partition_bin,
            "0x10000", app_bin
        ], check=True)
        print(f"✅ Merged firmware created at {merged_bin_out}")
    except subprocess.CalledProcessError as e:
        print(f"❌ esptool.py failed: {e}")

# Attach to firmware.bin specifically so this always runs after a real build
env.AddPostAction("$BUILD_DIR/firmware.bin", after_build)
