pietwauters/ImprovedTesterAfterGenova/(commit log)

2025-07-09 Initial commit. This is an improved version after feedback from peaople in Genova.
    [min_spiffs.csv]
2025-07-13 Improved calibration and individual measurements
2025-07-13 Fixed a bug where in return from deepsleep threashold were not initialized correctly
    [SettingsManager.cpp, SettingsManager.h, main.cpp]
2025-07-13 fixed Deepsleep bug and removed offset calibration
    [main.cpp, resitancemeasurement.cpp]
2025-07-14 Deepsleep delay can now be configured. Calibration is simplified and shows only one channel. You can select the channel or use auto mode
2025-07-14 Auto mode is not default for calibration, so no need to type it anymore
2025-07-15 Mirroring of the display is now a configurable setting, and no longer a compile opion
    [WS2812BLedMatrix.cpp, WS2812BLedMatrix.h, main.cpp]
2025-07-15 Removed code duplication af command handlers. Fixed \r problem for USBSerialTerminal
    [USBSerialTerminal.cpp, main.cpp]
2025-07-18 Added blinking led during wait mode. Fixed bug that always caused wiretest mode after returning from the other modes. Now after returning from other modes you end up in waiting mode unless you make a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
    [WS2812BLedMatrix.cpp, WS2812BLedMatrix.h, main.cpp]
2025-07-18 Fixed return from foil mode
    [main.cpp, resitancemeasurement.cpp, resitancemeasurement.h]
2025-07-20 All tester functionality remove from main and into tester.cpp. Improve foil testing, with debouncing and improved tests: Central-20mm and central - tip
2025-07-20 Improved epee testing: different color codes for acceptable resitances, Explicit point to central pin resistance measurement.
2025-07-20 LedPanel brightness is not a setting in the settings manager page
2025-08-15 Correctly store MirrorMode and Brightness into nvs
    [adc_calibrator.cpp, adc_calibrator.h, main.cpp]
2025-08-16 Initial resistor models with their calibration.
2025-08-26 Added foil probe mode
2025-08-26 Added Epee probe mode
2025-08-29 Integrated calibration model in the reference value array.Fixed a bug in the threashold calculation.
    [adc_calibrator.cpp, adc_calibrator.h, compensation_analysis.cpp, main.cpp, wire_analysis.cpp]
2025-08-29 Introduced new colorsheme for cable test: Green means: conform FIE. Yellow means, close to FIE specs, will likely pass weapon control. Orange: not conform FIE requirements, will probably not pass wea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
    [WS2812BLedMatrix.cpp, tester.cpp]
2025-09-17 Disable Wifi after 90 seconds, unless OTA ongoing; resolved flickering for Epee
    [SettingsManager.cpp, WiFiPowerManager.cpp, WiFiPowerManager.h, main.cpp, resitancemeasurement.cpp, resitancemeasurement.h, tester.cpp, tester.h]
2025-09-29 Added Warning screen for un calibrated device, and continue with default settings Removed all model calibration from main and moved into tester
2025-09-29 Fixed mV Volt confusion.
    [adc_calibrator.cpp, adc_calibrator.h, tester.cpp]
2025-09-29 Removed Differential calibration code, because it is not used anymore. Added version to settings web page.
2025-09-29 Cleaning up + show current calibration settings.
2025-10-01 Added possibility to ignore the fact that calibration is required. Will always fallback to defaults
2025-10-02 Added Reel test mode. This is basically a wire test, but with higher resistance thresholds.
2025-10-04 Fixed calculation for AverageLeadResistance
    [tester.cpp]
2025-10-20 Increased resistance to switch to special modes. Improved Reel mode: connecting top A-B toggles between reel and normal mode. In Reel mode there are no special (Lame, weapon) modes. Only cable testin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
2025-10-27 Fixed issue where it was impossible to get out of LameTop mode and switch to wire testing while aligator clip is connected
    [resitancemeasurement.cpp, resitancemeasurement.h, tester.cpp, tester.h]
2025-11-07 WireTesting2 now keeps the same color as in WirteTesting1, to avoid confusion.
    [tester.cpp, tester.h]
2025-11-08 Stay in wiretesting2 as long as there is at least one wire connected. Before this change, I went back to wiretesting1 after each issue during wiretesting2. This slowed down the whole process.
    [tester.cpp]
2025-11-08 Added orange to the lame tests up to 25 Ohm
2025-11-12 Modified implementation to singleton, and fixed a bug in getSecondsUntilTimeout() when Wifi is locked e.g. by OTA
    [WiFiPowerManager.cpp, WiFiPowerManager.h]
2025-11-12 Adapt code to singleton for WifiPowerManager; Showing the welcome lights is now configurable; Prepare to implement powersaving using DeepSleep.
2025-11-12 Fixed bug in Lamé testing. Resistance changes in both direction (better and worse) are now indicated.
    [tester.cpp, tester.h]
2025-11-13 Implement low power mode: During waiting mode, the device goes into deep sleep. Only during the short time that the led is on, all connections are checked, and a mode change can happen.
    [globals.h, main.cpp, tester.cpp, tester.h]
2025-11-14 Diamond is now hollow to save power.
2025-12-12 Added flag to force (re)calibration. Fixed a bug in calculating the resistance based on Vdiff.
    [main.cpp, tester.cpp, tester.h]
2025-12-13 Improved calibration based on relative errors i.s.o. absolute + multiple sequential improvements.
    [adc_calibrator.cpp]
2025-12-14 WIP: Implement three-layer measurement architecture with parallel testing
    - Add new measurement data structures (WireMeasurement.h/cpp)
    * Terminal enum for type-safe terminal references
    * Measurement class with normalized storage
    * MeasurementSet container with order-independent get()
    - Add three-layer architecture:
    * MeasurementHardware: Low-level ADC operations
    * MeasurementCapture: Orchestrates captures, bridges hardware to data
    * MeasurementAnalysis: Pure logic layer for wire analysis
    - Implement parallel testing in tester.cpp:
    * Main state handlers use new MeasurementSet API
    * populateFromLegacyArray() ensures single capture
    * Remove validation code after successful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
2025-12-15 Fix Reel mode bug: correct terminal check from Al-Cl to Al-Bl
    The bug was in handleWaitingState() line 155 where it checked Al-Cl instead
    of Al-Bl to exit Reel mode. This caused ReelMode to be incorrectly cleared
    when returning from wire testing, preventing the R symbol from displaying.
    Changed: currentMeasurements_.get(Terminal::Al, Terminal::Cl)
    To: currentMeasurements_.get(Terminal::Al, Terminal::Bl)
    This matches the main branch behavior which uses testAlBl().
    [MeasurementAnalysis.cpp, tester.cpp, tester.h]
2026-03-20 Foil, Epee and lame modes now show actual resistance values
2026-03-22 Added wiretests and fixed some issues in weapon testing (maostly display related)
    [DisplayManager.cpp, DisplayManager.h, main.cpp, tester.cpp]
2026-03-23 Updated settingsmanager with extra buttons with callbacks; Added reset to FIE thresholds
    [SettingsManager.cpp, SettingsManager.h, main.cpp]
2026-03-25 Improved optimization of r1_r2 and Correction (uses smaller steps and better range selection)
    [adc_calibrator.cpp]
2026-03-26 Fixed the use of double constants to single precision floats. This is a speed optimization. The default cast of 1000.0 is to double and not to float. So I now use 1000.0f instead. But more importantl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
    [adc_calibrator.cpp, adc_calibrator.h, tester.cpp, tester.h]
2026-05-03 Update foil circuit resistance measurement instructions
    Removed debounce timing information from foil circuit resistance measurement instructions.
2026-05-04 Show values larger than 50 Ohm, to be able to show to user that the problem is real; increase the leak thresholds for foil and epee; added a Blue F to indicate a possible leak.
    [DisplayManager.cpp, tester.cpp, tester.h]
2026-05-06 Implemented a basic leak test for foil
    [WS2812BLedMatrix.cpp, WS2812BLedMatrix.h, main.cpp, tester.cpp, tester.h]
2026-05-06 Spreadsheed based tool to create the array for leds
    [WS2812c Codegen.xlsx]
2026-05-07 Fixed bug where threasholds for reel mode were not initialized. Increased the values that are shown on the display (used to cap at 50 Ohm, is now 999 Ohm
    [DisplayManager.h, tester.cpp]
2026-07-29 Foil leak mode is now an option (default off) and there is a timeout to leave the loop. In detecting special modes, LameTop test has now the first priority such that even with a connected foild you c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
    [globals.h, main.cpp, tester.cpp]
2026-09-09 hw_rev2 bring-up: dual-revision build, RMT LED driver, rev2 glyph maps
    - platformio.ini / sdkconfig.hw_rev1 / sdkconfig.hw_rev2: per-revision envs
    (HARDWARE_REV 1/2); Hardware.h and DisplayManager.h gain rev2 pin/channel
    blocks.
    - WS2812B matrix moves off Adafruit_NeoPixel to a local RMT driver
    (NeoPixelRMT / NeoPixelI2S); NeoPixel data pin relocated on rev2.
    - WS2812BLedMatrix: R/E/F glyph tables get explicit #if HARDWARE_REV == 2
    branches of raw LED-chain indices (the rev2 panel is wired transposed vs
    rev1); Draw_R/E/F go through a trivial glyphIndex() helper. rev1 behavior
    unchanged.
    - main.cpp: hardware-revision boot banner; defer WiFi AP bring-up to loop()
    after welcome +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
2026-09-29 hw_rev3 bring-up: LED panel layout setting, wire-side mirroring, rev3 pins
    - New hw_rev3 env/pins: bl_driver GPIO15, PWR LED GPIO19, BOOST_EN GPIO21
    (enabled at the top of setup()), OLED/NeoPixel pins as rev2.
    - LED panel: all drawing now in user view (u = row*5 + col); glyphs are
    5-row bitmaps. The physical chain order is one runtime setting,
    LedLayout = <corner of LED 0>-<V|H>[-P] (8 snake layouts cover every
    rotation/mirroring). Per-board defaults: rev1/rev2 TL-V, rev3 BR-V.
    Replaces MirrorMode, CONFIG_15_20 and the hand-mapped rev2 glyph tables;
    legacy tables converted mechanically and verified pixel-identical on rev2.
    - LED_WIRE0_ON_LEFT (per board): wire content follows the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
    [DisplayManager.h, Hardware.h, WS2812BLedMatrix.cpp, WS2812BLedMatrix.h, main.cpp]
2026-09-30 hw_rev3: wake-on-connect deep sleep, sleep timeout in epee/foil/lame modes
    Replace the 2 s timer wake on hw_rev3 with an EXT1 wake-on-connect: Ar, Bl,
    Cl are held HIGH, Br, Cr, Al held as inputs with the internal pull-down, and
    their sense pins wake the chip (ANY_HIGH) when something is plugged in.
    Catches body cord, epee, foil, top lame and the reel short; bottom lame
    (Br-Cr) does not wake. The tester does not sleep while a wake pin already
    sees a connection. BOOST_EN and PWRLed are held low during sleep.
    hw_rev1/2 keep the timer wake.
    - DeepSleepHandler: pull-down hold pins, holds on digital pads too,
    releaseAllHolds() called early in setup() after a wake
    - 10 s grace period after a wak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
    [DeepSleepHandler.cpp, DeepSleepHandler.h, globals.h, main.cpp, tester.cpp, tester.h]
2026-10-01 Turn OLED off (display + charge pump) before entering deep sleep
2026-10-08 Calibration over Wi-Fi: web API, model store, guided script (phase 1)
    Calibrate the tester without a serial cable. The tester gets a
    Calibrating state driven by a /api/cal/* web API; tools/cal_wizard.py
    walks the operator through it.
    - adc_calibrator: split into measure(path), fit(), evaluate() and the
    model maths; interactive fine-tuning removed. Verdict per point on
    resistance error: <= 2 % excellent, <= 5 % pass, else fail (not saved,
    serial calibration included)
    - CalibrationPaths: Cl-Cr (default, used for all thresholds) and Bl-Br.
    The old serial calibration measured Bl-Br; it now uses Cl-Cr
    - CalibrationStore (NVS "cal_store"): model per path, previous model for
    undo, ring o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
    [CalibrationPaths.h, CalibrationService.cpp, CalibrationService.h, CalibrationStore.cpp, CalibrationStore.h, adc_calibrator.cpp, adc_calibrator.h, cal_wizard.py]
2026-10-08 Calibration wizard page served by the tester (phase 2)
    Open http://192.168.4.1/calibrate (or /cal) on the Tester Wi-Fi: a
    step-by-step calibration page for phone, tablet or laptop, no install.
    - web/calibrate.html: resistor sets kept in the browser (add/edit/delete,
    bookmark link #set=Name:values, export/import), guided steps with a
    to-scale socket drawing (A-B 15 mm, B-C 20 mm), auto-capture of stable
    readings, wrong-resistor check from this run's own points (independent
    of the old calibration), result with verdict and per-resistor errors,
    save/undo/repeat, live resistor check, history of runs from every tester
    calibrated in this browser; leaving the page ends the session
    - ext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
    [CalibrationPaths.h, CalibrationService.cpp, CalibrationService.h, adc_calibrator.cpp, cal_wizard.py, extra_script.py, tester.cpp]
2026-10-08 CLAUDE.md: code terminal letters vs physical sockets, Wi-Fi calibration
    - Mapping table: code C/A/B are physical sockets A/B/C (internal order
    C-A-B); operator-facing text must use the physical letters
    - Clean up the cable reel paragraph; note that the trigger table uses code names
    - New section on the Wi-Fi calibration layer; Calibrating state
    - .gitignore: cal_runs.jsonl (personal calibration run records)
2026-10-08 Calibration fit: least squares on relative resistance error
    fit() now minimises the squared relative resistance error over R1_R2 and
    Correction (Nelder-Mead), the quantity the verdict judges, starting from
    the previous voltage fit and never returning a worse model. V_gpio stays
    at the open-circuit V_top.
    On the two real hw_rev3 runs the worst point drops from 2.18 / 2.04 % to
    2.03 / 1.89 %. Minimax (lower worst point, worse prediction of
    unmeasured resistors) and a free V_gpio (fits to an impossible 6.6 V)
    were tried and rejected.
    [adc_calibrator.cpp, adc_calibrator.h]
2026-10-08 Calibration readings in both current directions (experiment)
    During a calibration session every reading takes its first half forward
    and its second half with the drive reversed (the other output pin high),
    reported separately. The fit still uses the forward half, so the saved
    model matches how the tests measure.
    - adc_calibrator: measure(..., bidirectional), sampleChannels() helper
    - /api/cal/sample: v_top_rev_mv, v_bottom_rev_mv, v_diff_rev_mv
    - Page and cal_wizard.py keep the reversed half in the run record;
    run records may now be 1024 bytes
    - tools/cal_analyze.py: refits every run forward, reversed and averaged
    - CalibrationStore::getRun reads into the heap, not the web task's stack
    R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
    [CalibrationService.cpp, CalibrationService.h, CalibrationStore.cpp, CalibrationStore.h, adc_calibrator.cpp, adc_calibrator.h, cal_analyze.py, cal_wizard.py]
2026-10-08 Firmware version: unique per build, written on every build
    update_version.cmake was garbled (two versions interleaved), so the
    version header was only written when CMake reconfigured and every build
    reported a stale `git describe`. Repaired, and extra_script.py now writes
    version.h into the build dir on every PlatformIO build (only on change).
    Builds from a modified tree get the build time appended
    (v3.5.0-5-g409b563-dirty+20261008-1635), so calibration run records can
    tell test binaries apart.
2026-10-08 Bidirectional measurements everywhere; hw_rev3 default model
    getDifferentialSample now takes half of its samples with the drive set by
    the last Set_IODirectionAndValue and half with the current reversed (the
    other of the two output pins high), and returns the average. All 21 drive
    configurations drive exactly two pins, so every measurement reverses; call
    sites are unchanged. Reversing mirrors every node voltage, so the sign of
    a reading is kept. This cancels offset/gain differences between the ADC
    channels and about half of the ADC nonlinearity: on two hw_rev3 testers
    the RMS calibration error drops from 0.9 % to 0.5 %.
    - Calibration measures by averaging exactly these readings, so the mode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
    [CalibrationService.cpp, CalibrationService.h, CalibrationStore.cpp, CalibrationStore.h, MeasurementHardware.cpp, MeasurementHardware.h, adc_calibrator.cpp, adc_calibrator.h]
2026-10-08 Calibration page: contact check, tester MAC in header, name in run records
    - Each resistor is captured twice with a reseat in between; the two
    captures must agree within 0.5 % (or 4 sigma of the window noise if
    larger), else the page asks to clean/reseat and captures again, up to
    4 times, then lets the operator start over or use the closest pair.
    The mean of the agreeing pair is used. Run records keep per resistor
    [captures needed, spread %] as "contact"
    - Header shows the last 5 characters of the MAC (F5:4C, C1:20)
    - Run records (page and cal_wizard.py) include the device name;
    cal_analyze.py prints it and the contact check
    Motivation: tester F5:4C read all six resistors ~0.8 m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
    [cal_analyze.py, cal_wizard.py]
2026-10-08 Measurements: unbiased rounding of the bidirectional average
    getDifferentialSample returns the average of both halves in whole mV and
    rounded an odd sum (x.5) up: every reading came out ~0.24 mV high on
    average, 0.7 % at 1 Ohm. Calibration averaged the exact halves, so the
    OLED read slightly higher than the calibration reported. Odd sums now
    round to even (no bias), and calibration averages the readings exactly as
    the tests get them. Calibrations made since bidirectional readings were
    introduced stay valid (they were fitted on the unbiased halves).
2026-10-08 Phase 4: measure how the model reads the other connections
    The tester has one calibrated model (socket A top to bottom) but the
    tests also measure other connections. Before giving connections their
    own models, measure how accurate the single model is on them.
    - CalibrationPaths: all 15 connections with drive configuration, ADC
    channels and physical end points (from/to); the drive configurations
    are the ones MeasurementCapture uses (code Al as piste). Verified that
    every entry drives and senses the terminals its end points name
    - /api/cal/info: "ends" per path ("sockets" kept for straight paths)
    - tools/cal_validate.py: guided measurement of the resistor set on the
    chosen connections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
2026-10-08 Calibration model M2: internal series resistance instead of c/R
    V_diff = V_gpio (R + Ri) / (R + Ri + Rs), R = Rs V / (V_gpio - V) - Ri,
    clamped at 0. Rs is everything outside the sense points (2 x 33 Ohm plus
    the GPIO drivers), Ri the resistance between them (traces, vias, socket
    wiring). On all ten runs it fits as well as Rs + c/R (worst 1.15 % vs
    1.02 %), while the old model's negative c on hw_rev3 was Ri in disguise
    (c ~ -Rs*Ri) and had no solution below ~0.3 Ohm: the OLED showed invalid
    values for good body cord wires and lead compensation switched off. Ri
    also explains the C-C offset (Ri_C - Ri_A ~ 0.14 Ohm on both testers).
    - Errors count relative to max(R, 1 Ohm); verdict 2 % / 5 % u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
    [CalibrationService.cpp, CalibrationStore.cpp, CalibrationStore.h, adc_calibrator.cpp, adc_calibrator.h, cal_analyze.py, cal_validate.py, cal_wizard.py]
2026-10-09 Model: driver resistance rises with the current (fixed slope 400 Ohm/A)
    Rs_eff = Rs + s * I outside the sense points; V = Vg (R + Ri)/(R + Ri + Rs_eff),
    R = Rs_eff V/(Vg - V) - Ri. Both directions stay closed formulas (one
    quadratic each). s is a fixed 400 Ohm/A for all hardware revisions:
    measured from the raw voltages it is mostly the high-side (sourcing)
    GPIO driver, 356-468 Ohm/A on two hw_rev3 testers, consistent with the
    ESP32 output drivers. Only Rs and Ri are calibrated, so a set without a
    high resistor still works.
    On 13 runs: 54.7 Ohm from +3.3..+4.4 % to -1.1..+0.3 %, and the range up
    to 10 Ohm improves too (mean worst 1.56 -> 1.38 %, left-out 2.82 -> 2.35 %).
    - EmpiricalModel.d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
    [CalibrationService.cpp, CalibrationStore.cpp, CalibrationStore.h, adc_calibrator.cpp, adc_calibrator.h, cal_analyze.py, cal_validate.py, cal_wizard.py]
2026-10-09 cal_validate: allow 1 to 8 resistors; report the difference in mOhm
    With fewer than 4 resistors no own model is fitted; per connection the
    script reports how the tester's model reads each resistor, now also as a
    difference in mOhm (a constant offset such as the internal resistance of
    a connection shows directly). cal_analyze prints the same.
2026-10-09 Thresholds and readings per connection (hw_rev3 correction table)
    The calibrated A-A model reads other connections up to ~0.15 Ohm and ~2.6 %
    off (different internal series resistance and drive resistance per
    socket; C bottom is ~0.1 Ohm higher on both hw_rev3 testers). Each
    connection now gets a correction R = scale * R(A-A model) + offset.
    - CalibrationPaths.h: CalPathIndex, PathCorrection, defaultPathCorrection()
    with the hw_rev3 table pooled from two testers (cross-checked: a table
    from one tester halves the other's error, RMS 72 -> 35 mOhm); identity
    for A-A, mode-detection-only connections and other revisions
    - Calibrator: resistanceFor(path, V) and mvThresholdFor(path, R, lead)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
2026-10-09 Calibration measures B-B and C-C: the tester's own correction for both wires
    After the A-A resistors the page asks for two resistors (closest to 1 and
    4 Ohm from the set) on socket B and on socket C, with the contact check.
    For each, /api/cal/correction fits scale and offset relative to the A-A
    fit of this session (weighted like the calibration) and reports how far
    the hw_rev3 table is off at 1 Ohm; the page warns above 50 mOhm ("check
    that socket"). Save stores them with the A-A model; they replace the
    table values for B-B and C-C and are applied without reboot.
    - CalibrationStore: saveCorrection/loadCorrection (NVS k_<path>)
    - CalibrationService: pending corrections (cleared by a new fit)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
2026-10-09 Validation shows corrected readings; docs for per-connection corrections
    cal_validate.py applies the correction the tester uses on each connection
    (from /api/cal/info) and shows the A-A model alone next to it, so the
    improvement is visible per connection; records keep the correction.
    cal_analyze.py applies it too. CALIBRATION_API.md and CLAUDE.md describe
    the corrections, the B-B/C-C calibration step and the per-connection
    thresholds.
2026-10-09 Calibration page: wait for readings after switching connection
    Switching from A-A to socket B empties the tester's averaging window; the
    first samples then carry no voltage, and the new capture step crashed on
    them ("Cannot read properties of undefined (reading 'toFixed')"), which
    ended the session right after the last A-A resistor. waitFor() now skips
    samples without readings. The mock tester used for the browser test now
    returns empty samples after a path switch, like the firmware, so this is
    covered.
2026-11-05 Setting to enable or disable cable reel mode
    Unticked, an A+B short on top no longer arms reel mode, and an armed
    tester leaves the mode. Default on, so behaviour is unchanged.
